lleck/PercussiveInterface-3/4_Layer_Board/Notes.txt

###############TO-DOs###########################################
*IMPACT
    |
    |___
        * via Hall effect sensors (how to calibrate ?)
          enough resolution via 3.3 reference voltage?
          switch to teensy 3.6 with 1.2Vref ?

        Interpolation for radial position detection ?

                distance between sensors 7mm
                ---|___|---|___|---|___|---|___|
                 S  7mm  S  7mm  S  7mm  S  7mm

        algorythm could possibly consider nonlinear readings (thus threshold) along the radial sensor array
        --add readings of neighbours, check for threshold and calculate proportional distribution of reading, for maximum radial resolution

        possibly one gets away with a resolution of 2*NumSensors per AngularReading. checking for 64 tresholds/ positions on the radial dimension. One reading perpendicular to each Sensor plus one reading perpendicular to the middle between 2 Sensors

*VELOCITY:
 While we hope to have reasonable time between single impacts on the skin (e.g. 400bpm = 6,67Hz) there will be a sort of phasing in the readings as they will either occur while the magnet is falling or rising. At 75 Hz there is ca. 10 readings between impacts at stupidly fast drumming of 400bpm, hopefully enough to average out the position.
 A time measurement between a first and a second treshold could possibly generate usable velocity readings if the rotor wasn't moving.
 With a moving Rotor we get a local samplerate of the rotational Frequency (e.g 1500rpm = 25Hz / 4500rpm = 75Hz)
 For reliable velocity readings we need to track the nanoseconds until a certain peak is reached, thus we need a much higher samplerate.

 Sampling another impact Sensor for the whole surface at a higher rate could provide velocity readings which we could map to position readings.

*SURFACE / Sticks / Hands etc.:

 -When hitting with the hands, capacity measurements of a steel mesh drumskin could provide impact readings
 -If using the hands, we want to break down different regions of the hand and mark them with magnets in order to derive useful parameters for synthesis. Gloves are a reasonable result adressing those needs.

 -When using Sticks, the readings are less complex but capacity is harder to derive. Sticks might connect to a ground plane through a thin wire, when using a metal mesh skin

 -Velocity sensing below the Skin allow for a different design of the skin. even a translucent layer of plastic with a film of silicon for the rebound, a standard Meshhead or else is possible

 -other Possibilities:
   Gauge Sensors, Piezoelements, resistive Sensors (velostat)

 ################ Component Details #############################

*SS39ET Hall Effekt Sensor
https://www.farnell.com/datasheets/2007294.pdf
    -3.3V
    -6mA (192mA)
    -1.4mV/Gauss -> lower reference Voltage in µC
    -response time 3µS
    -measures magnetic polarity

*Radial-Ring_Magnets
    -outer southpole -> left Hand
    -outer northpole -> right Hand

*APA 102 2020 RGB LED
https://www.mouser.com/datasheet/2/737/APA102_2020_SMD_LED-2487271.pdf
    - 5V
    - 40mA  max. each white full brightness -> 2A
    - adressable
    - ca. 0.5A for 64 leds or less with lower brightness (adafruit)

*µC Teensy 4.1
    - 3.3V (5V supply input)
    - ca. 100mA max
    - 600 mHz M7 processor
    - 2 adc
    - AREF = Supply 3.3V (Teensy 3.X can go lower)
    - interleaved reading possible

################ Sensor Data Transmission #####################
*ESP-01
    - unstable firmwares (server crashes)
    - as OSC Client
    - has OSC Library (https://github.com/stahlnow/OSCLib-for-ESP8266)
    - or NodeMCU LUA Firmware ?

*Serial via IR Light (open optocoupler)
    - less parts, no network hustle
    - retro-compatible
    - 5 pin midi jack on the instrument
    - low resolution

############### Motor PWM from RPM transmission #################
Motordriver Board needs updated PWM for stabilisation of the rpm

*Serial via IR Light
    -TO-DO: speed Test/ calculation

*ESP-01 Wifi transmission could serve both needs
