lleck/PercussiveInterface-3/Master_Thesis_Lukas_Leck.pdf

# MEMBRANE SURGERY

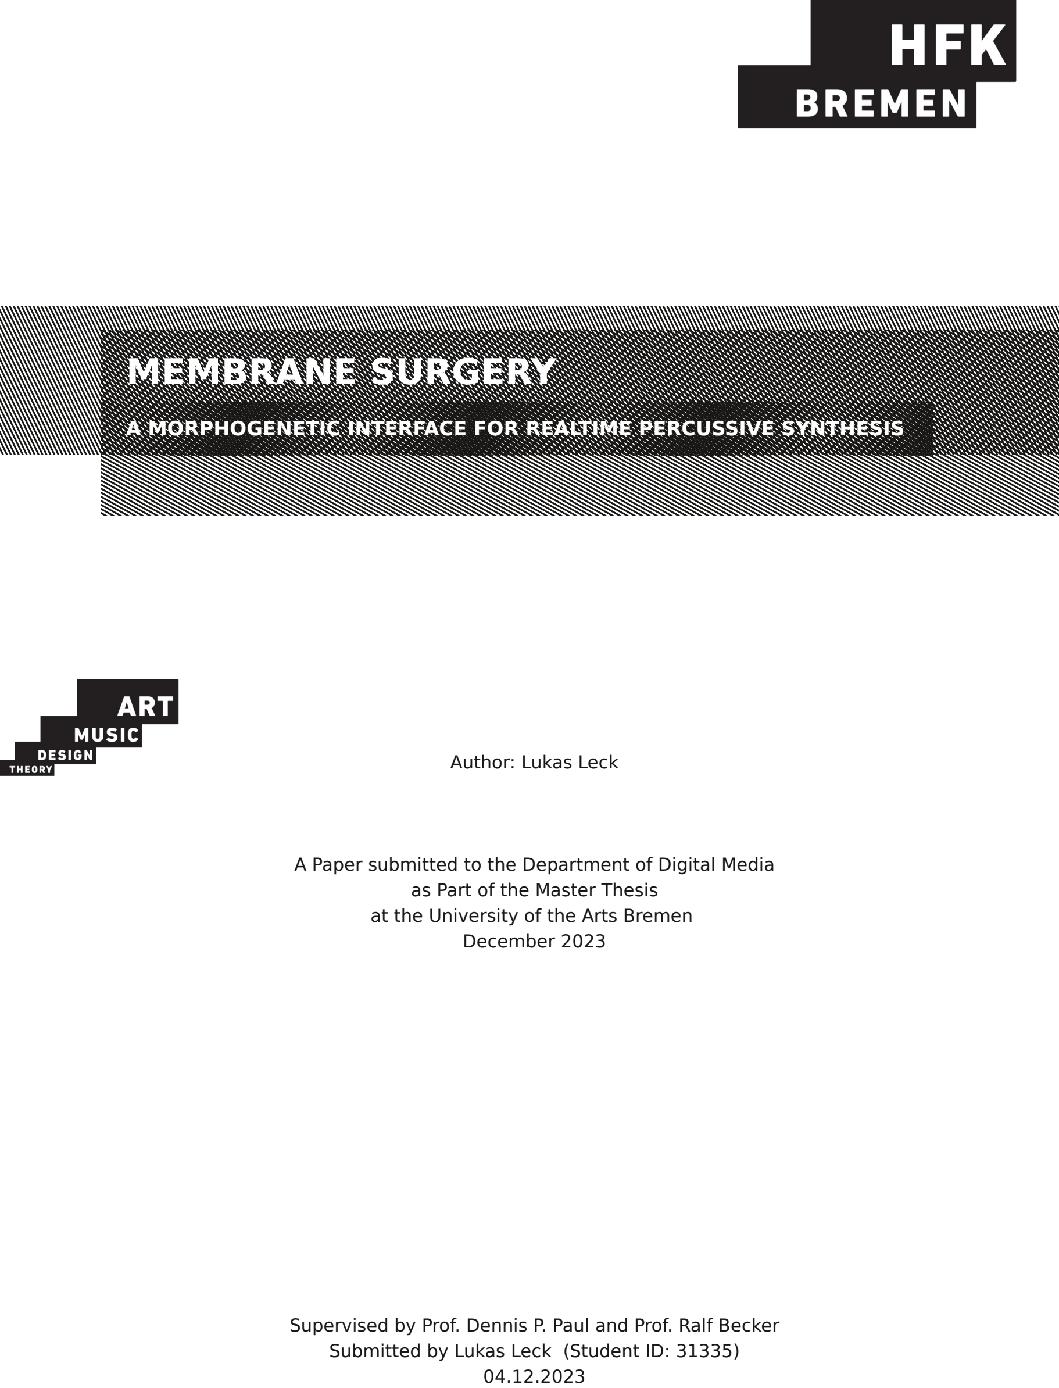
[picture p1: page 1]

Author: Lukas Leck

A Paper submitted to the Department of Digital Media as Part of the Master Thesis at the University of the Arts Bremen December 2023

Supervised by Prof. Dennis P. Paul and Prof. Ralf Becker Submitted by Lukas Leck (Student ID: 31335) 04.12.2023

A MORPHOGENETIC INTERFACE FOR REALTIME PERCUSSIVE SYNTHESIS

Membrane Surgery - written submission of the master thesis - Lukas Leck 2023

### TABLE OF CONTENTS

ABSTRACT
1 | INTRODUCTION
2 | RELATED WORK
2.1 | percussive interfaces
2.2 | position data
2.3 | display interfaces
3 | METHOD
3.1 | brief description
3.2 | design decisions
3.3 | electronics design
3.4 | circuit board design
4 | FUTURE WORK AND DISCUSSION
5 | REFERENCES
5.1 | Literature
5.2 | Images
6 | SCHEMATIC

3
4
5

7

12
13

14

Membrane Surgery - written submission of the master thesis - Lukas Leck 2023

### ABSTRACT

This paper describes a musical interface built to control percussive synthesis algorithms in real time. This interface records data about the position and intensity of a strike on a mesh fiber drum head, while projecting a full color display onto that very head. The display is created by the means of a persistence of vision (POV) setup, whereas the data for synthesis is captured by an array of magnetic field sensors and a single near field optical sensor. This interface could be used as a controller to perform with many different synthesis algorithms or dedicated synthesizers. The integrated display allows for the interface to take all kinds of shapes in order to assist the performer in controlling the targeted medium. It could provide visual feedback representing certain synthesis parameters, split up the drum head into smaller zones, plot text or even draw animations. The target is, to offer a platform for the development of dedicated applications focused on the percussive performance.

Membrane Surgery - written submission of the master thesis - Lukas Leck 2023

The relentless advance of display based interfaces into every aspect of our life, has not stopped at the musical domain. In the recent century a plethora of music software for touch-screen devices has been released. The simultaneous increase in computing power allows for complex sound synthesis, sophisticated enough to render the iPad a legit musical instrument to perform on stage. Hence the popularity of those platforms, the average consumer touchscreen device lacks a lot of features of a dedicated musical instrument or interface built for live performance and stage environment. This is particularly true when it comes to percussive interfaces, as the nature of the physical interaction of the drummer with the drum limits the design possibilities of those interfaces compared to those of e.g. a keyboard player. A glass covered touch screen just can't take the beating.
This paper describes the design of a digital percussive instrument that is capable of drawing a graphical interface onto a circular drum skin, while concurrently collecting and processing various data points representing position and force of impacts measured by
various | sensors | below | the | skin.
The | resulting prototype | represents | a
percussive interface for sophisticated drum
synthesis | with | the | flexibility | of | a
touchscreen device while providing the morphology of a drum as expected by the percussionist.

To achieve this, a mesh fiber drum head as used in electronic drum kits is augmented by a rotating disk beneath, which holds an array of multi color RGB LEDs as well as an array of magnetic hall effect sensors. On the display side the led array provides for the technical prerequisites of a persistence of vision (POV) display known to many by gadgets like led desk-fans which employ the technique to draw patterns or messages with their spinning rotors (Figure 1).

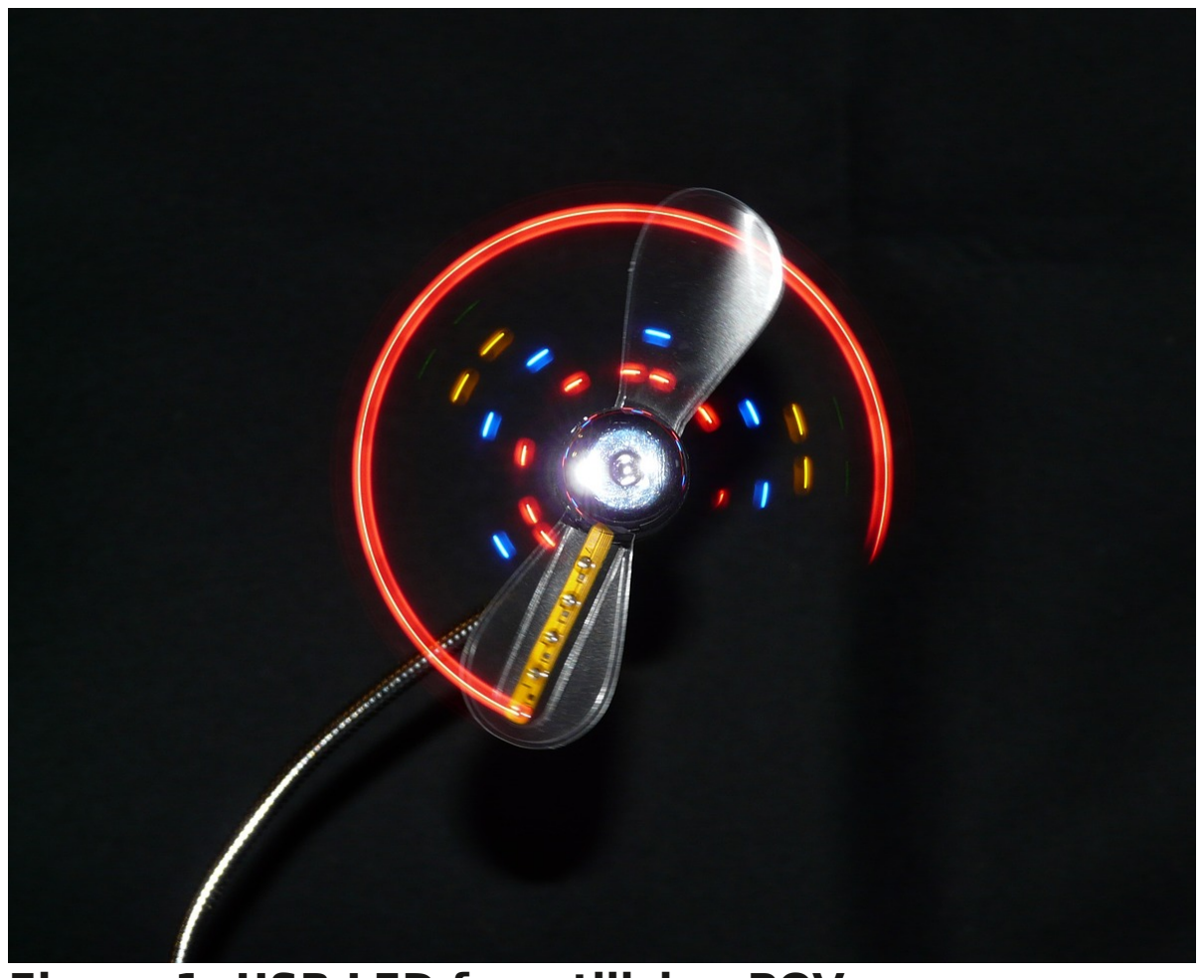
[picture p2: figure]

On the sensor side the same principle is somewhat turned around by adding an array of hall effect sensors, which are used to record data about magnetic fields above the drum head. All incoming and outgoing data is processed by an ESP32 micro controller (µC) sitting on the same PCB as the LEDs and sensors. The disk is rotated by a dc motor and the power is transmitted to the rotating body through a conductive coil setup as known to many by wireless charging modules for smartphones. To complete the design the tips of the drumming sticks need to be equipped with small permanent magnets.
The current design offers a rugged drum with natural physical response that can take a beating and is capable of drawing a full
color | interface | onto | the | skin | while
representing many relevant interactions with high resolution data points.

### 1. INTRODUCTION

Figure 1: USB LED fan utilizing POV

Membrane Surgery - written submission of the master thesis - Lukas Leck 2023

1)https://www.keithmcmillen.com/products/boppad/2)https://korg.com/de/products/en/drums/wavedrum/

A broad overview of the strategies used to sample useful data in percussive interfaces is provided by Tindale et al.
[1]

. The large
majority of electronic percussive instruments and controllers on the market make use of piezo transducers which translate impacts into voltage and can even be used to determine the position of strokes when put in relation to another. This can be seen today in many electronic drum pads and kits of various manufacturers. Another common method is the use of force sensing resistors (FSR) made of a material that varies in electrical resistance relative to the force applied. The cross-talk between adjacent sensors is decreased massively compared to piezo elements. These can also be found in various percussive interfaces on the market, with a prominent example being the Bop Pad¹⁾

. Yet another technique to obtain useful data for percussive synthesis is the use of microphones. The Wavedrum²⁾

is a very
successful | implementation | combining
original sound with synthesis and sound-processing based on the input of three contact mics.

One can already see different attempts to make use of position data in the percussive interfaces described, but there are methods focusing more on that topic. An early example being the radio baton[2] developed

### 2. RELATED WORK

### 2.1 percussive interfaces

### 2.2 position data

3)https://sunhou.se/sensorypercussion by Max Mathews at the infamous Bell Labs in the 1970s. It makes use of two radio emitting batons that are used on a rectangular drumming-surface with radio antennas. A concept birthed as a three
dimensional | computer | mouse | further
developed by Matthews to easily perform sheet music with an individual touch. Here one can already see a potential percussive interface generating high resolution position data in three dimensions. From that point on the increase in computing power has
opened | up | a | lot | of | possibilities.
Sophisticated realtime input data analysis is performed by machine learning algorithms in an approach by Tindale et al.
[3] paving
the way for products like the Evans Hybrid Sensory Percussion³⁾

. Another method worth
mentioning is the use of computer vision.
T. Mäki-Patola et al.
[4] used a webcam
mounted underneath the skin of a djembe drum to obtain a 3d image of the hands above the skin by analyzing the shadow
displacement. | Proper | lighting | is | an
important aspect in this setup, as one can guess.

The touchscreen is the number one interface for human machine interactions since the manufacturers of smartphones
have | conquered | the | markets | of all
developing | economies. | People | quickly
adopted their behavior to the new and fascinating coplanarity of input and output. Interface designers put great effort into nurturing the users memory for the new and competing gestures. While many young folks will intuitively develop the skills to interact with screens on their very surface, other folks are having a hard time keeping up with speed. A feeling of nostalgia is

### 2.3 display interfaces

Membrane Surgery - written submission of the master thesis - Lukas Leck 2023

FSRs and multi color LEDs, their method gets much closer to an actual color display,
capable | of | drawing | many | different
interfaces. Finally a project based on a traditional glass covered touchscreen is worth mentioning here, as the sound synthesis performed in this device is very closely attached to the interactions on that screen. Victor Zappi et al.
[5] made a giant
touchscreen interface for their physical
modeling | synthesis | algorithm | when
developing "The Hyper Drum Head". The performer draws free-form shapes onto the screen, thereby creating a virtual physical space in which the sound-waves, excited by strokes on the screen, resonate. This way a magnitude of possible sounds can be created very creatively. While this example lacks the possibility to beat the interface with a stick, it clearly showcases the potential that flexible display interfaces can offer the developer and the performer.
surrounding | dedicated | single | purpose
interfaces, equipped with knobs, buttons and tiny segmented displays. A feeling that has paid in its contribution for a boom of electronic music devices. The market is flooded with tiny little synth boxes, compact drum machines, samplers and effect units often times emphasizing the analog nature of their sound synthesis. In other examples they are based on building a dedicated interface around a microcomputer executing a single piece of musical software. If there is something to learn from these observations then it's potentially that there are certain shortcomings of the ubiquitous touch-screens especially when it comes to the creative musical process. At the same time nostalgia will pass with each gene-ration and the benefits of on-screen interactions are simultaneously developed by musicians and researchers in the field. Thus there are a few examples of (potentially) percussive on-screen interfaces to discuss here.
A certain range of midi controllers can be
summarized | under | the | term | 'grid-
controllers' and one of the first appearances is the monome⁴⁾

. The smallest version, the monome-64 is little more than an eight by
eight | momentary | button | matrix | with
a back-light under each of its translucent silicone pads. It was originally developed to control the visual programming environment MaxMSP⁵⁾

. The possibility of adjusting the interface with different illuminations makes it a versatile and effective tool, yet far from offering any percussive qualities. The field of inventions and products building on the same concept reach into a area that is slightly more relevant for percussive use, by replacing the buttons with sensors such as FSRs. The Linnstrument 128⁶⁾ by Roger Linn might be an example worth mentioning here. A concept transcending further from the limitations of a grid is the Erae Touch⁷⁾
by | the | french | company | embodme.
By scaling up the grid resolution of both

4)https://monome.org/
5)https://cycling74.com/products/max6)https://www.rogerlinndesign.com/linnstrument7)https://www.embodme.com/

Membrane Surgery - written submission of the master thesis - Lukas Leck 2023

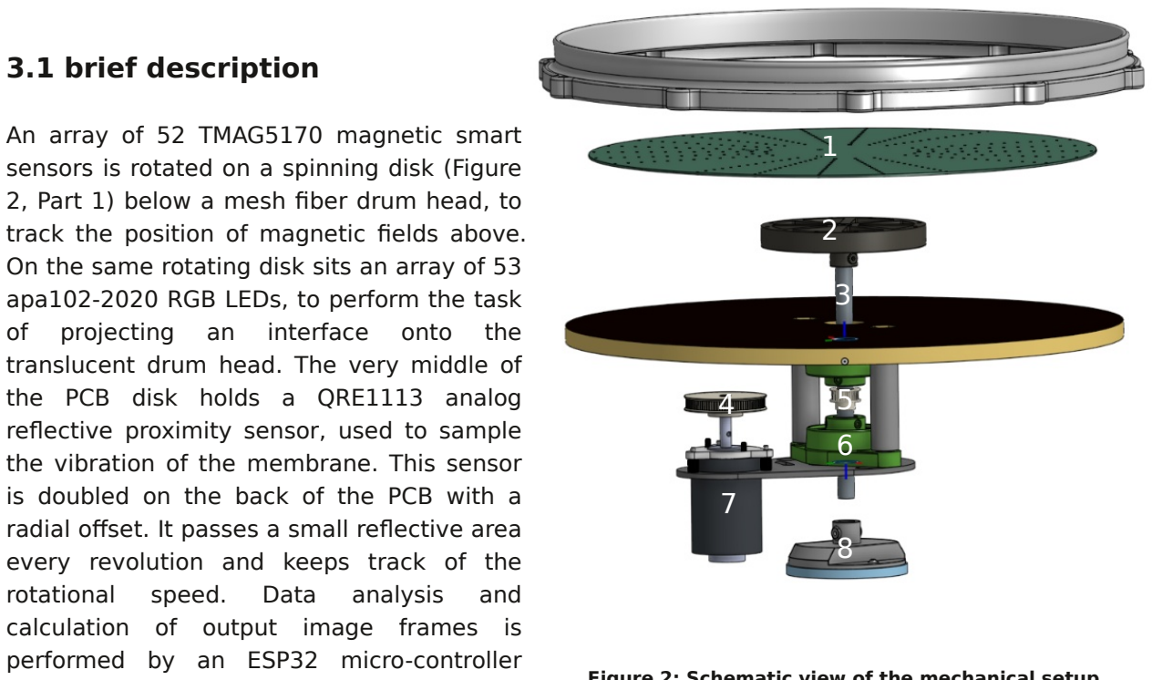
[picture p3: figure]
An array of 52 TMAG5170 magnetic smart; of projecting; interface; onto; the; the PCB disk holds a QRE1113 analog; every revolution and keeps track of the; rotational; speed.; Data; analysis; and; calculation of output image frames is performed by an ESP32 micro-controller; 3.1 brief description

Diving into the technical details of this
method | can | partly | be | achieved | by
describing the path of design decisions and
preceding | experiments | during | the
development. Searching for a way to display an interface onto a drum head there are several options coming to mind. A limitation being the possibility of the membrane to vibrate, in order to achieve a natural behavior and respond as expected by the drummer. Thus the displaying devices needs to shine the interface onto that membrane without touching it. This is where projection comes to mind as the image can be mapped to the shape of a drum easily, although this comes with the cost of a projector that either fits into the drum or a setup that

### 3. METHOD

1

sensors is rotated on a spinning disk (Figure 2, Part 1) below a mesh fiber drum head, to track the position of magnetic fields above. On the same rotating disk sits an array of 53 apa102-2020 RGB LEDs, to perform the task

translucent drum head. The very middle of

reflective proximity sensor, used to sample the vibration of the membrane. This sensor is doubled on the back of the PCB with a radial offset. It passes a small reflective area

(µC) sitting on that same disk. The disk is mounted on top of a 12mm hollow shaft (Figure 2, Part 3) with a 3d printed adapter (Figure 2, Part 2). The shaft is supported by two ufl203 bearings (Figure 2, Part 6) and driven by a 12V dc motor (Figure 2, Part 7) connected by the means of a GT2 timing belt. In order to drive the disk at high speeds, a transmission ratio of 1:3 is realized through the use of a 30 teeth pulley on the 12mm shaft (Figure 2, Part 5) and a 90 teeth pulley on the motor shaft (Figure 2, Part 4). Power is transmitted wireless to the rotating parts by the means of a conductive coil setup as used to charge smartphones without a cable. The power cables are passing the core of the hollow shaft. The receiving coil with its circuitry is attached at the lower end of the 12mm shaft through a 3d printed part (Figure 2, Part 8). It is facing the static transmitting coil placed below with a little air gap in between.

### 3.2 design decisions

Figure 2: Schematic view of the mechanical setup

Membrane Surgery - written submission of the master thesis - Lukas Leck 2023

As discomforting it may be and has been to the author, one is not getting away without some numbers and cold blooded math at this point. In order to get an idea, if the design meets the real world needs, there are several numbers one should gather to perform some calculations. These can be justified assumptions, as for example the
playing | speed | of | the | percussionist
performing the instrument. Or they can be standards that have established over the course of history, like the upper limit of 10ms latency in realtime sound synthesis. Ignoring such a limit would plainly render any musical controller useless, even for the amateur performer with non-skilled ears. Taking the latency limit as a starting point, it is now important to walk along our signal path's and determine, which components pay into the time account. First we have our LEDs as the output path. There are many different RGB LEDs on the market. A large group of analog ones, requiring digital logic to switch them, which takes a lot of controlling outputs from the µC or output multiplexing which in return asks for more components and available space on the printed circuit board (PCB) . A second group formed by digital ones controlled through a protocol like I²C or SPI. This allows a large number of them to be connected to the µC by a few wires. To cut the story short the RGB LED aimed for in this project is the apa102-2020, mainly because it comes in a 2x2 mm package, allowing for denser pixels compared to the ubiquitous 5x5 mm package. It features a standard SPI interface and a refresh rate of 20kHz translating to
0.05ms | per | refresh. | That | is | plenty
enough to perform some visual magick.

requires several parts to be setup and calibrated each time. Either way one shall not get into the way of the light beams with your hands, sticks or sensoric electronics. A different approach would be a form of circular LCD screen that fits under the drum head leaving a gap between the membrane and the display. The lack of available circular displays bigger the size of a smart watch made for an easy decision. Which leads us to the concept of POV displays. This concept further illuminated in the next chapter, gets along with a single array of rotating LEDs to produce a circular image leaving enough space on the rotational body for further electronics such as sensors to accumulate data of the overlaying surface and space above. While growing fond of the idea of a spinning display, this imposed new problems on the overall design.
First of all, a decision had to be made, which components of the design should be spinning around and which parts can remain static. Most of all the question, how to interconnect these parts. In order to stop the pondering about, a decision has been made to find a way of fitting all electronic parts onto the spinning body. This is leaving only two connections (power and ground) to find their way onto the spindle. A problem of a very different kind comes with the indifference of humans visual and auditory perception. Where an array of LEDs can make for a perfect illusion of a fluid image when switched and spinned at rather modest frequencies, the human ear is capable of perceiving latencies of a few milliseconds, with musicians ears being unsettlingly faster than the average. This means the sensoric electronics need to perform their task much faster than the LEDs in order to provide data for sound synthesis at an acceptable rate. This has obviously influenced the last major part of the design decisions in this project being the choice of electronic components.

### 3.3 electronics design

Membrane Surgery - written submission of the master thesis - Lukas Leck 2023

Those numbers are kept in mind nonethe-less. Facing the input side of the project, one is confronted with the sheer infinity of different sensors available. Before settling on a certain type of sensor it seemed wise to decide on some of its specifications first. That way one hopefully ends up with a greater choice of components. To gather these specs we are again assuming a target latency below 10ms. But before diving into the datasheets one has to realize that the very first limiting factor here, is the speed of rotation. While many digital sensors offer update rates of several thousand Hertz , it is the rotational frequency that determines how often a certain sensor is passing point x on the surface. Soon one comes to the realization, that for "musical" update rates,
velocities | of | hundreds | of | thousands
rotations per minute are necessary (e.g. 5ms(p) ≙ 5kHz ≙ 300.000 rpm). Time to look further into the data one actually needs to perform the synthesis of a percussive sound and how they relate to our timing problems.

A percussive sound (Figure 3) consists of the onset marking the very beginning of the sound, a tone or timbre consisting of certain frequencies, their relative level to another and their change over time until no more sound is present. Sounds described as percussive share a feature that is called a short attack. The overall level of the sound takes very short time to reach perceptible loudness. They are often times decaying towards silence at slower speeds from that point on, with slower decaying sounds offering more perceptible differences in tone and timbre. Looking at the data to control these parameters one can now divide them into those relevant for the timing, namely the impact on the drum head, its exact time, intensity and the duration of decay and those relevant to the timbre of the sound, namely the exact position of the impact and maybe a suggestion about the mass or size of the impacting object.
When the exact onset time of the impact is much more critical to latency, while less so is the data influencing tone and timbre, one can potentially devide these tasks in the design of a percussive interface. The critical impact detection shall however be solved before any other design decisions are made. In this method this was achieved by placing a QRE1113 infrared reflective sensor in the very middle of the PCB so that it is targeted towards the center of the drum head. The sampled data is representing the intensity of reflection, which itself is relative to the distance of the drum head. Sampling this data is achieved by the ESP32 µC and is performed with absolute priority at high enough samplerates to satisfy our latency demands. Impact-onset and duration of decay as well as the frequency of vibration are now represented. With this out of the way, one can now think about the other data relevant to this project. What kind of sensor is able to detect the presence of an object (and ideally its distance) at high enough rates, to offer useful data. Bearing in mind it is being spinned around performing the task. An optical sensor has fitted the needs earlier, though now the membrane is in its way rendering all light beam reliant methods useless. Opting for Texas Instruments TMAG5170 3d Hall effect sensor instead was done out of various reasons. Firstly, great amounts are available in stock at the time building this project. Secondly, it is priced reasonably enough to

Figure 3: A percussive sound with its maximum level almost coincident with its onset

Membrane Surgery - written submission of the master thesis - Lukas Leck 2023

polar coordinate system by the means of assigning them to an angular, radial and axial distance. The radial distance is represented by the index of the sensor in the physical array. Its distance from the center is a constant and can be further divided by the means of interpolation. The axial distance is relative to the strength of the field, which leaves us with the angular position. As described earlier, a second optical reflective sensor is attached to the bottom of the PCB at a known radial offset, passing a small reflective point once per revolution. This point is declared the reference point of 0°. By sampling the time it takes for our disk to perform a full revolution (T) one can keep track of the rotational speed as well as derive an angular displacement of the sensor array with the following formula:

T for the exemplary 3300rpm equals 1/55 seconds, resulting in ω≈345 with the unit 1/s. Now one can multiply ω with the time (t) that passed since the reference point to obtain an angle expressed in radians. This value can be multiplied by 180° and divided by π to convert it into degrees. The obtained position data is constantly updated to an array. Whenever an impact is recorded, the latest position data is collected from that array. This way the latency of data arrival at the output, relative to the impact, is kept as short as possible. Changes in position are not expected to be performed at audio rates so these can be sampled at slower rates. As the TMAG5170 sensor can detect a magnetic field a few centimeters away, it allows for the record of position data ahead of an impact, as well as the option to pipe out that data individually for contactless interaction three dimensions.

8)a comparision of the readings of two adjacent sensors, to determine a relative position inbetween double the amount on the PCB, resulting in two opposite arrays, subsequently doubling the samplerate at point x on the surface. Finally because it is a smart sensor package that offers complete signal conditioning, integrated analog to digital conversion (ADC) and the fast and stable SPI interface mentioned earlier. This interface relies on a clock signal, a data input path and a data output path shared among all devices, leaving only one individual connection - the chip select signal (CS) - which selects the slave device (TMAG5170) talking with the
master | (ESP32 | µC). | The | necessary
infrastructure is fulfilled with only two more components (ADG731 32-channel multiplexers) distributing these CS signals from two output pins of the µC to the 52 slave devices. The TMAG5170 sensors being sensitive to magnetic fields on the z-axis perpendicular to their surface mount package, offer the convenience of detecting the distance of a permanent magnet above at a rate of 20.000 samples per second. One
can | calculate | the | resulting | circular
resolution of the spinning sensor array with the following formula:

if one inserts the samplerate f(s) of 20kSps and assumes an exemplary rotation of 3300rpm, one can possibly perform 727
readings | per | revolution, | theoretically
allowing for an angular resolution of 1° with ~110Sps @ point x on the surface (alternatively an angular resolution of 0,5° with ~55Sps at point x). Combined with the possibility of interpolation⁸⁾

there is plenty of
room to experiment with the algorithm gathering the position data from the hall effect sensor array. The measured magnetic field strength can easily be mapped to a

Membrane Surgery - written submission of the master thesis - Lukas Leck 2023

mind and preferably close to the center, yet it is impossible to evenly distribute all weight, while designing a PCB like this. The long array of components cutting the circle in half, are the 52 hall effect sensors, with a small interruption in the middle by the optical sensor. The vertical array in Figure 4 are the 53 RGB LEDs above the ESP32 microcontroller, which is framed by the two multiplexers. The circuit board is designed with industrial top layer assembly

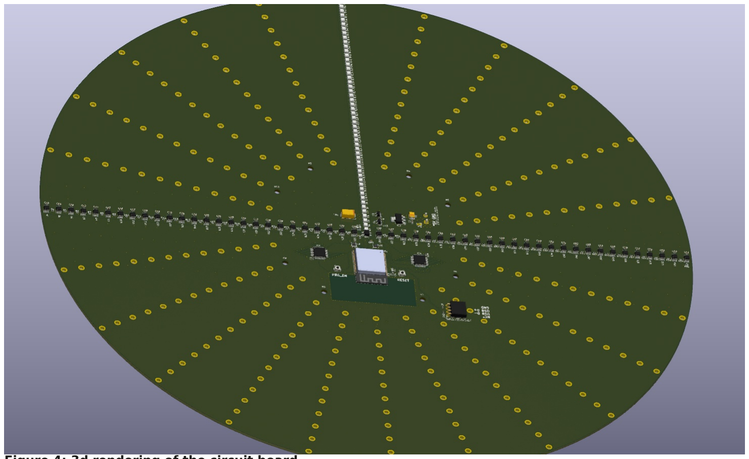
[picture p4: figure]

in mind, in order to save cost and time. As a result only three components need to be soldered by hand on the bottom side. The stackup of the board is four layers, with two signal layers enclosing a ground- and a powerplane. The full schematic of this board is attached to this document.

The design of the PCB justifies a few separate lines in order to explain its unusual appearance (Figure 4). The spinning disk mentioned repeatedly consists of this very PCB. This decision was made to reduce the overall mass of the moving parts to eliminate vibrations due to unbalance. The same reason explains the beams of 2mm plated holes spreading out from the center. These holes can be populated with small copper rivets in the necessary process of balancing the disk. The other components on the board were placed with balance in

### 3.4 circuit board design

Figure 4: 3d rendering of the circuit board

Membrane Surgery - written submission of the master thesis - Lukas Leck 2023

### 4. DISCUSSION AND FUTURE WORK

At the time this paper is written, the prototype has yet to be assembled and programmed. The preceding text resembles an in depth description of the concept and design of this instrument, and documents the work incorporated to this point. The targeted implementation of this project resembles an early prototype. It has yet to be tested in various use cases to reveal all its potentials and deficits. There are certain considerations for improvements of the overall design, that came up during the process of development, which ask for further investigation. As usual with a project of this scope, one has to decide for a moment to actually release the work into existence, postponing a lot of considerations to a future version. To name a few here, the mechanical design for example, is based on the hope to omit problems of instability by
choosing | very | sturdy | heavy | parts.
Therefore, a future version may become
substantially | lighter | and | slimmer | by
investigating | further | into | the | actual
mechanical | loads | on | the | chassis.
Furthermore the choice of the skin and the hoop were first of all based on availability. The skin shall be evaluated in its qualities as both a membrane and a canvas for the graphical interface. The hoop might be replaced by a flatter type in order to reveal more of the outer perimeter of the skin. The motor driving the disk might as well be exchanged in order to save space and cost, as the one used in this project is quite bulky and offers far more torque than required in this project. Additionally the whole drive train could potentially see improvements in order to silence emerging sounds. Which leads to the question of the final enclosure for the drum, which obviously is a substantial part of its appearance, as well as the amount of noise emitted from the drive train. In that regard a traditional drum format is targeted, where the performer can comfortably place it on the lap as well as the potential to mount it onto a stand, when performed in conjunction with a set of other percussive instruments or a drum set. All future improvements set aside, it already appears, how this interface can serve as a novel platform for the development of specific synthetic percussive applications. The characteristics of this interface are calling for programs developed to embrace them. In other words, it may perform well enough as a drum pad, by visually dividing up its surface to control different sounds in existing software. The bigger potential however, lies in the careful mapping of all the different output parameters to certain sonic features. It requires a corresponding responsive user interface projected onto its skin, guiding the performer through the manipulation of that membrane. This interface calls for the possibility to integrate the creation of these interfaces into itself, making the setup an intuitive creative process. Many such programs could be developed and performed from that single interface. This way it could be turned into an evolving organism, revealing its true morphogenetic features. To approach these daring fantasies a lot of UI work is ahead of the developer.

Membrane Surgery - written submission of the master thesis - Lukas Leck 2023

[1] A. R. Tindale, A. Kapur, G. Tzanetakis, P.
F. Driessen, and W. A. Schloss. A comparison of sensor strategies for capturing percussive gestures. In NIME, 2005
[2] M. Mathews. The radio baton and conductor program, or, pitch, the most important and least expressive part of music. Computer Music Journal 1991
[3] A. Tindale, A. Kapur, G. Tzanetakis, and I. Fujinaga. Retrieval of percussion gestures using timbre classification techniques. International Symposium on Music Information Retrieval, 2004
[4] T. Mäki-Patola, P. Hämäläinen, and A. Kanerva. The augmented djembe drum -sculpting rhythms. In NIME, 2006.
[5] Victor Zappi, Mike Frengel, Andrew Stewart Allen, Sidney Fels. The Hyper Drumhead: A Musical Instrument For The Audio/Visual Manipulation Of Sound Waves. SIGGRAPH Conference, 2022

Figure 1: Image of a rotating led fan shot by the user Hans-2
file accessed on 30.11.2023 link:
https://pixabay.com/photos/fan-rotation-wing-subjects-52107/

Figure 2: screenshot taken from CAD software used in the design process

Figure 3: screenshot taken from a waveform of a ppercussive sound, representing loudness relative to time

Figure 4: 3d rendering of the circuit board designed in the free software KiCAD EDA Suite

5. REFERENCES | 5.1 Images

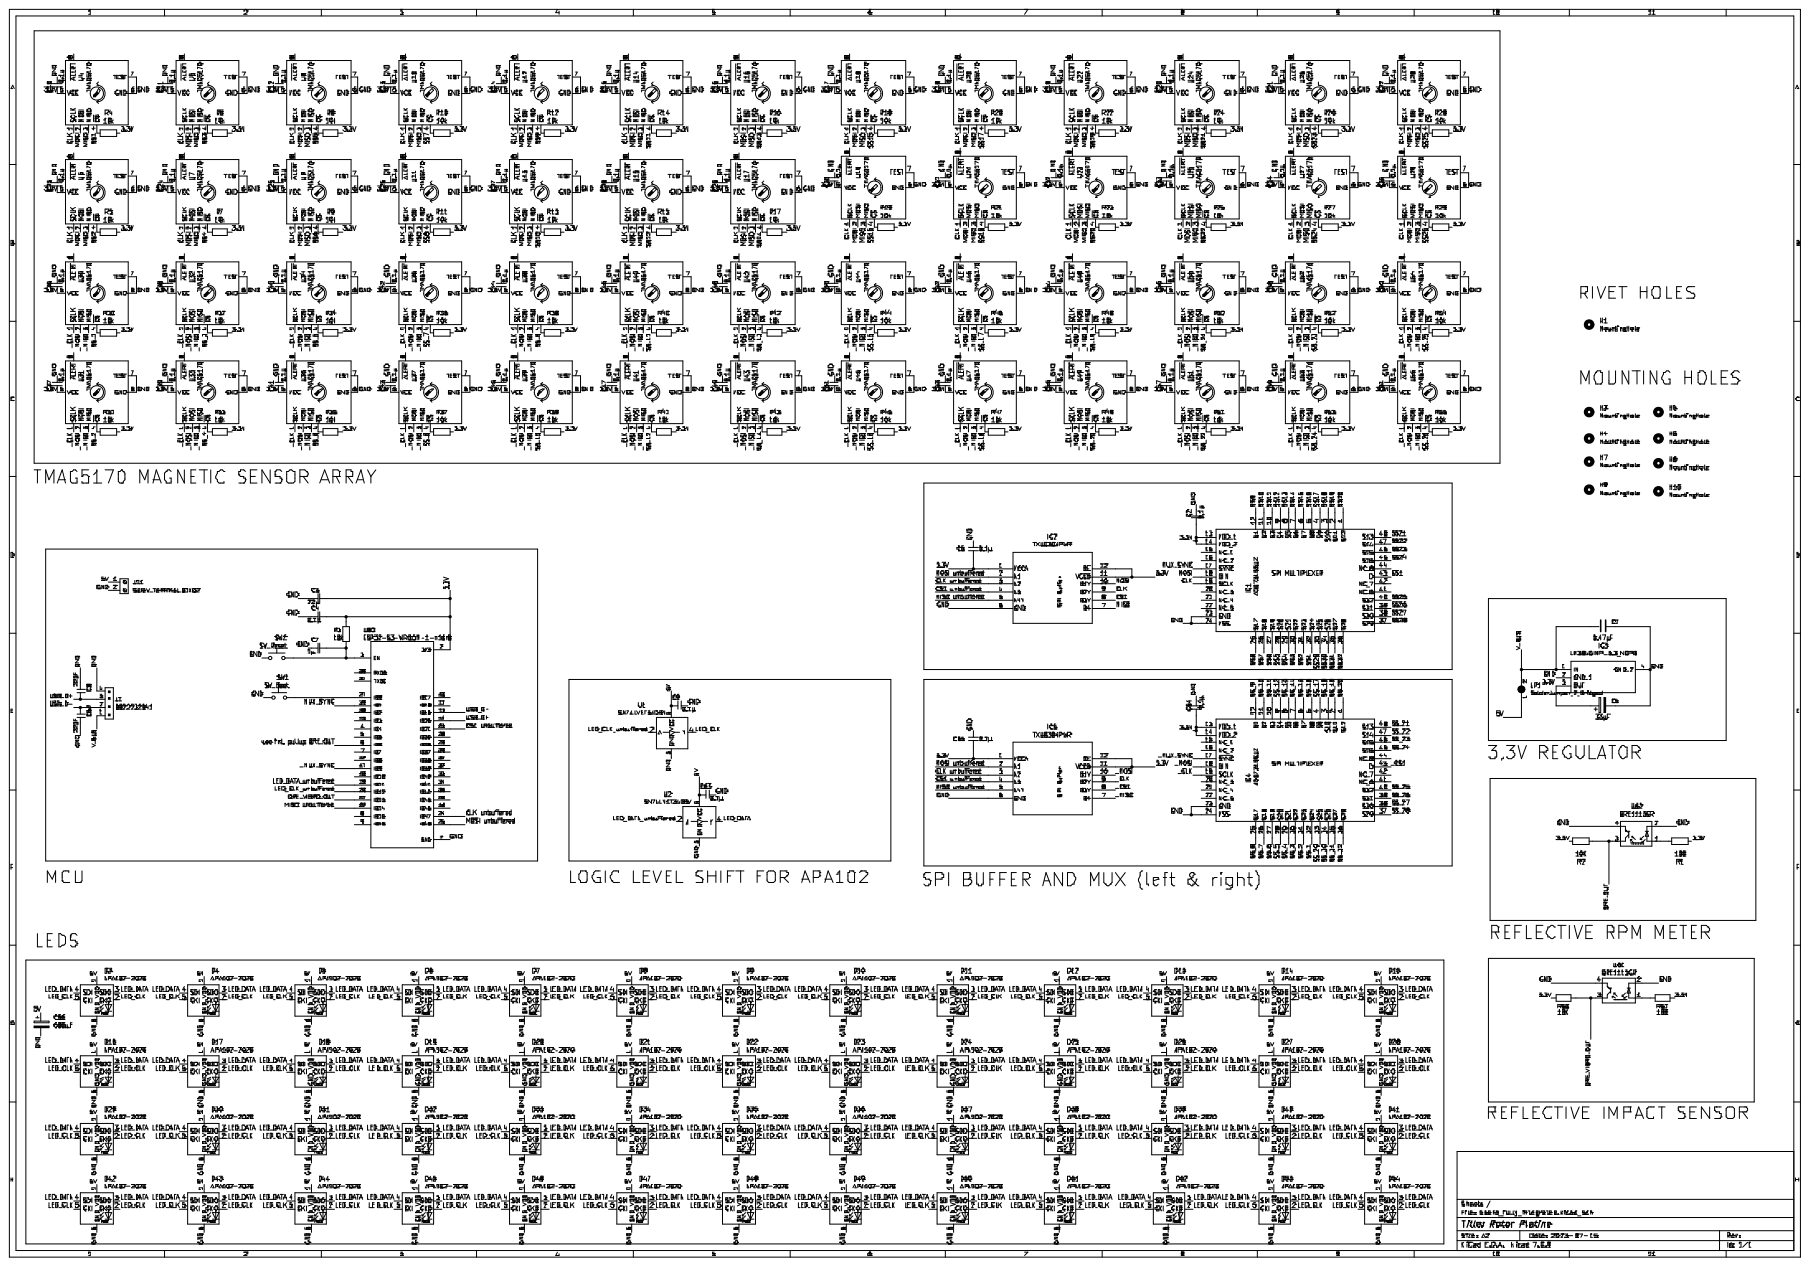
[picture p5: page 14]
