lleck/PercussiveInterface-3/percussiveInterface-3.2/ARRAY_Connector.png

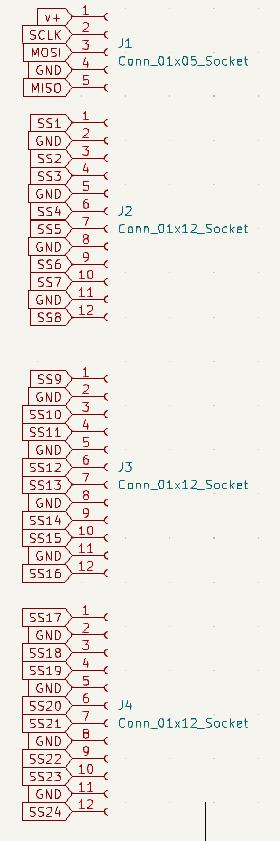
percussiveInterface-3.2/ARRAY_Connector.png
