lleck/PercussiveInterface-3/percussiveInterface-3.2/magneto_array.png

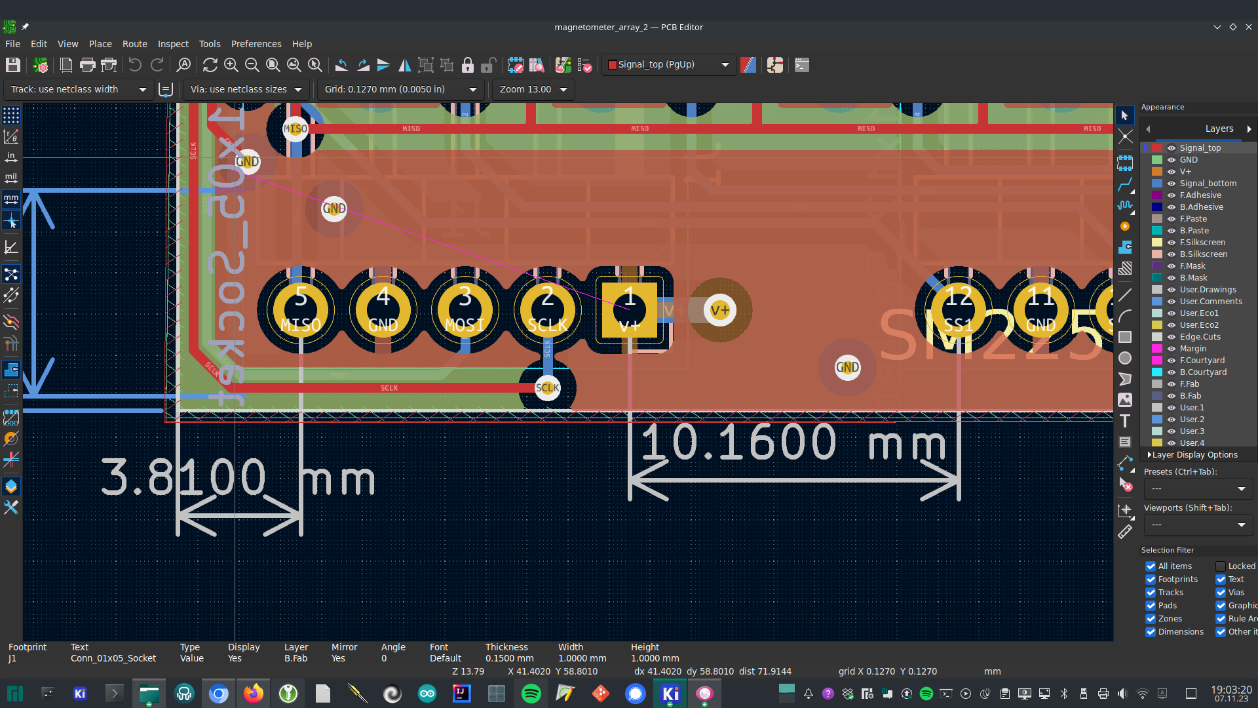
percussiveInterface-3.2/magneto_array.png
