lleck/PercussiveInterface-3/percussiveInterface-3.2/new_board_fully_integrated/board_fully_integrated_zoom_2.png

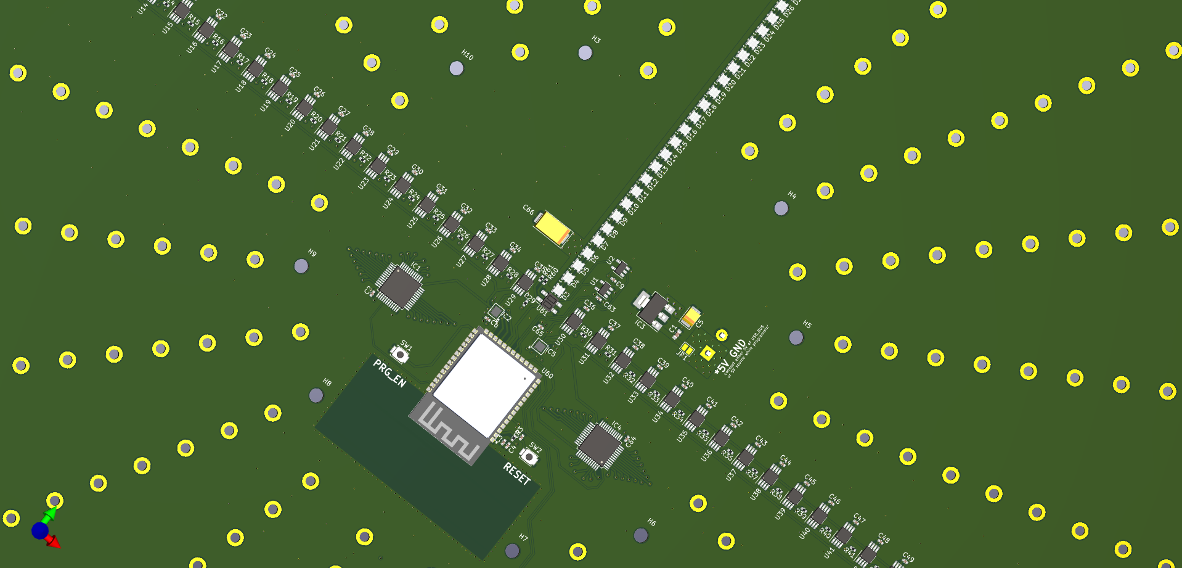
percussiveInterface-3.2/new_board_fully_integrated/board_fully_integrated_zoom_2.png
