lleck/PercussiveInterface-3/percussiveInterface-3.2/Screenshot_20231107_152231.png

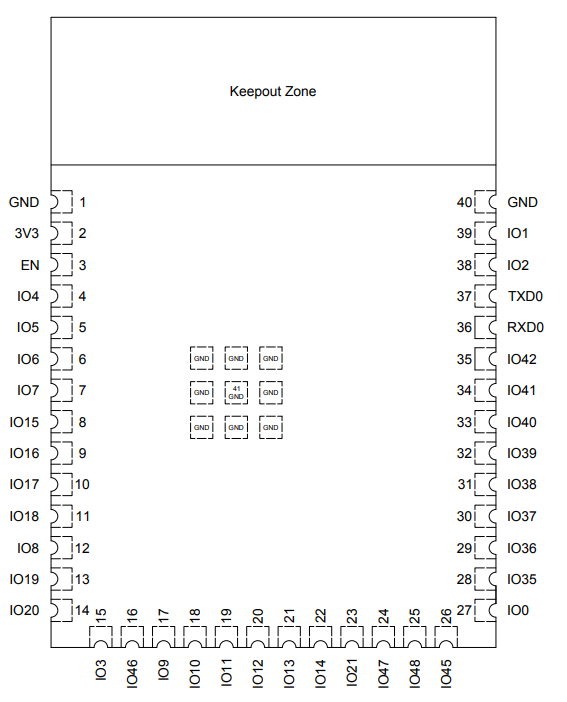
percussiveInterface-3.2/Screenshot_20231107_152231.png
