lleck/PercussiveInterface-3/percussiveInterface-3.2/Screenshot_20231114_114413.png

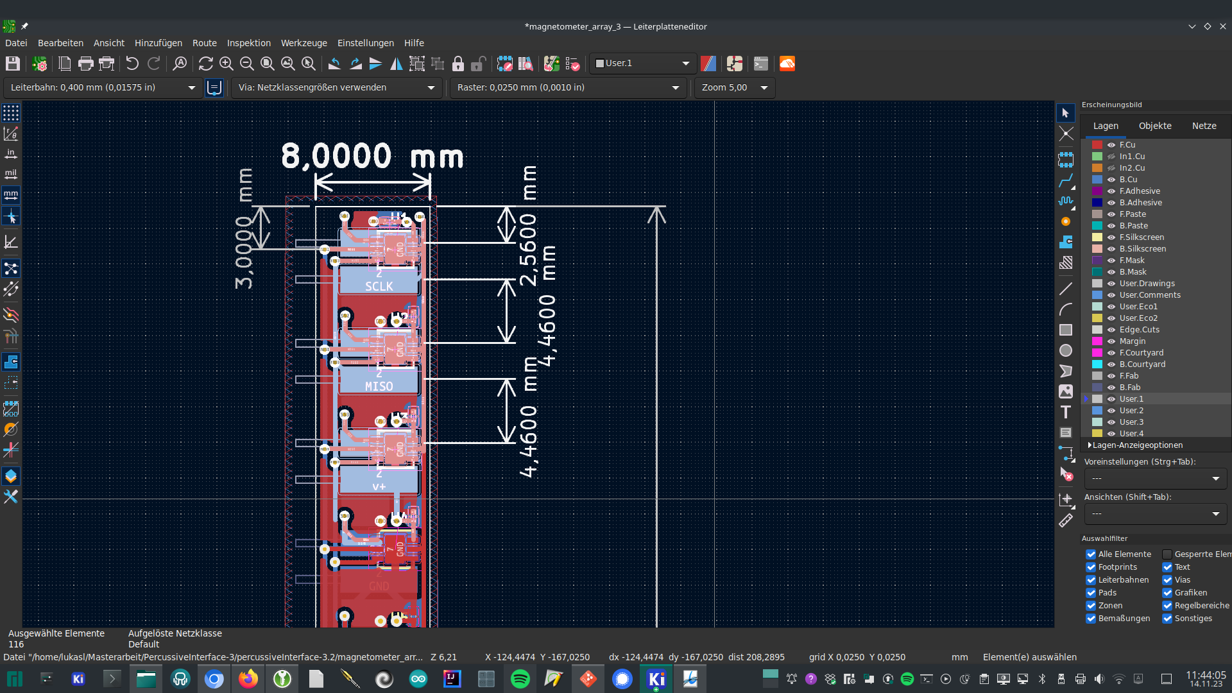
percussiveInterface-3.2/Screenshot_20231114_114413.png
