lleck/PercussiveInterface-3/percussiveInterface-3.2/Screenshot_20231114_115530.png

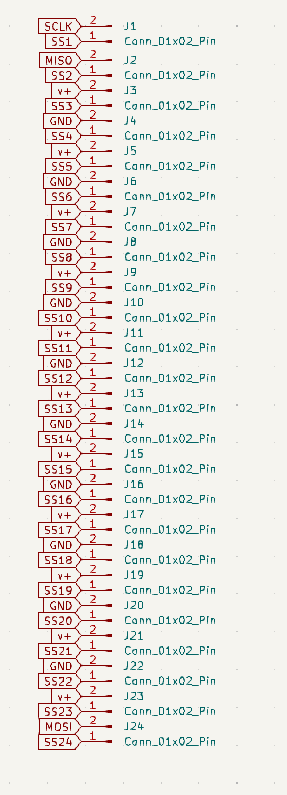
percussiveInterface-3.2/Screenshot_20231114_115530.png
