lleck/PercussiveInterface-3/percussiveInterface-3.2/Screenshot_20231114_170810.png

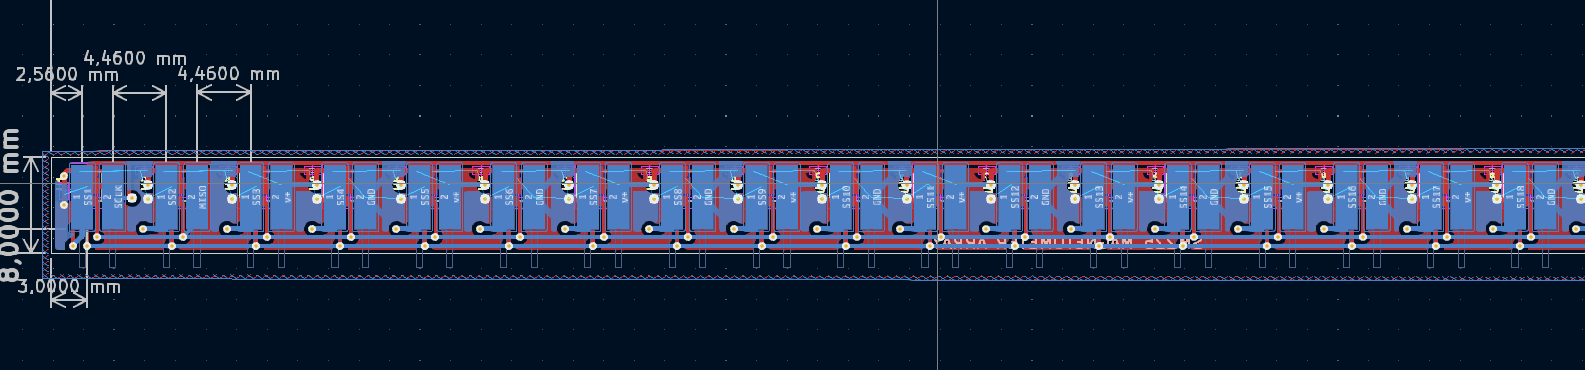
percussiveInterface-3.2/Screenshot_20231114_170810.png
