lleck/PercussiveInterface-3/percussiveInterface-3.2/main_board_4_jlc/jlcpcb/goods_nomenclature_code.png

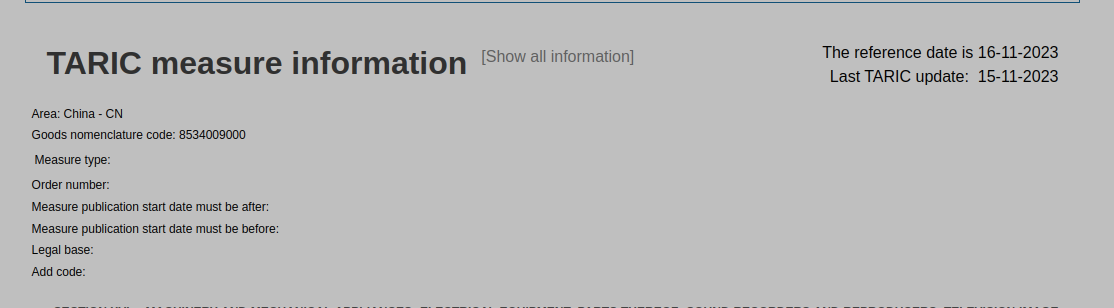
percussiveInterface-3.2/main_board_4_jlc/jlcpcb/goods_nomenclature_code.png
