lleck/PercussiveInterface-3/drill_template.stl

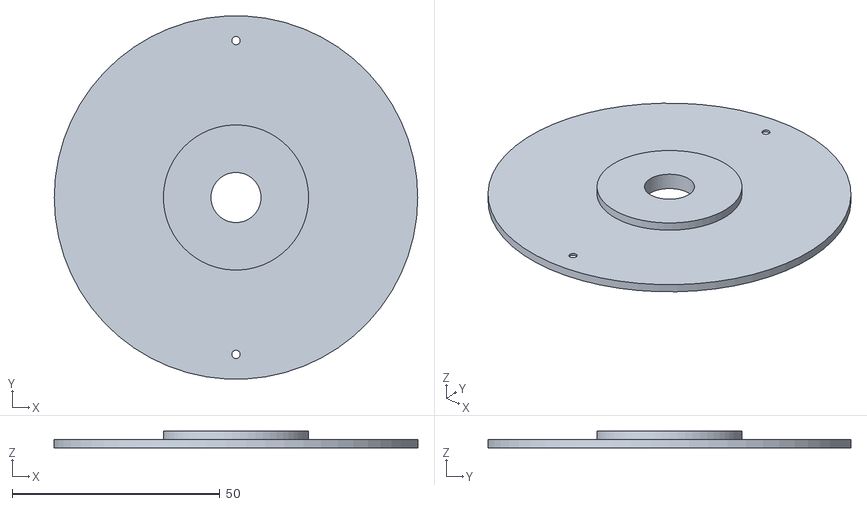
[picture p16: CAD file, 2024-01-07]
drill_template.stl
87.5 x 87.4 x 4.00
