lleck/PercussiveInterface-3/Footprints/BSW-112-04-T-S/BSW-112-X-X-S.step

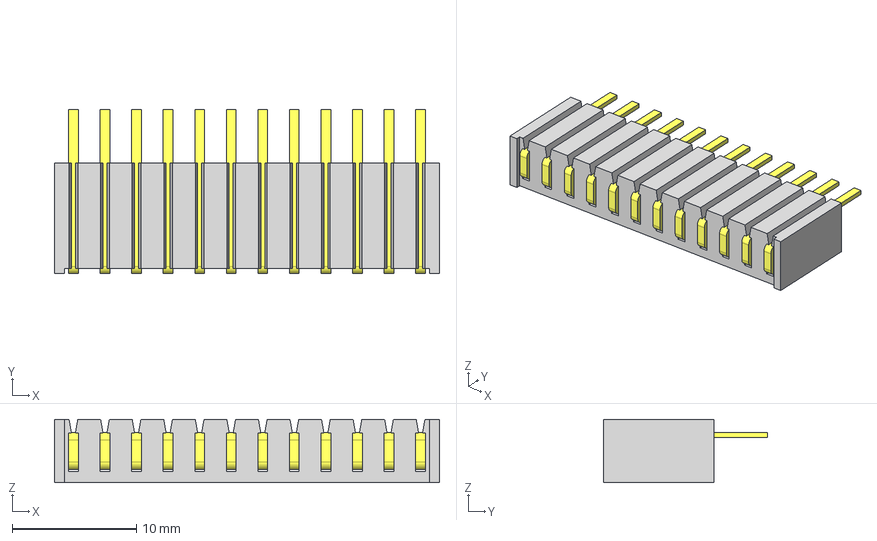
[picture p17: CAD file, 2023-11-09]
Footprints/BSW-112-04-T-S/BSW-112-X-X-S.step
31.0 x 13.2 x 5.08 mm
C-8-5-01-12-S
BSW-12-04-S_socket
