lleck/PercussiveInterface-3/Footprints/BSW-120-X-X-S/BSW-120-X-X-S.step

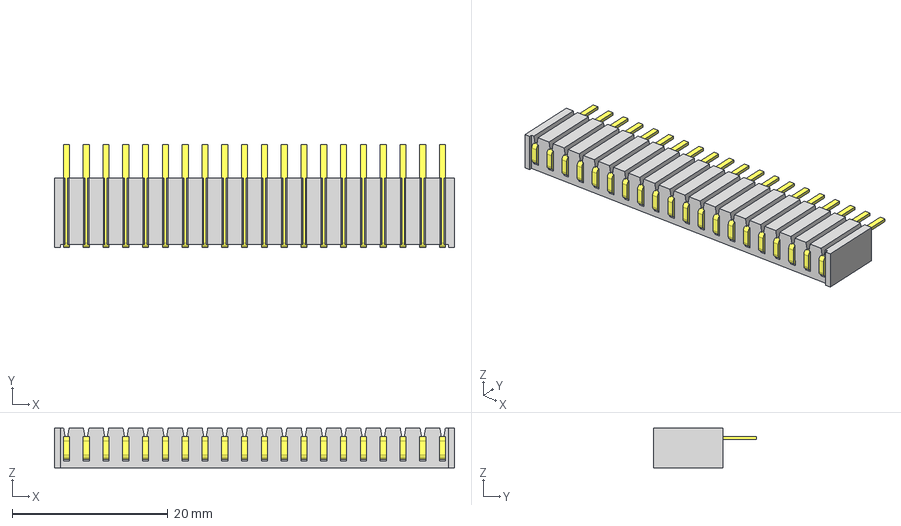
[picture p18: CAD file, 2023-11-03]
Footprints/BSW-120-X-X-S/BSW-120-X-X-S.step
51.3 x 13.2 x 5.08 mm
C-8-5-01-20-S
BSW-20-04-S_socket
