lleck/PercussiveInterface-3/Footprints/BSW-134-X-X-S/BSW-134-X-X-S.step

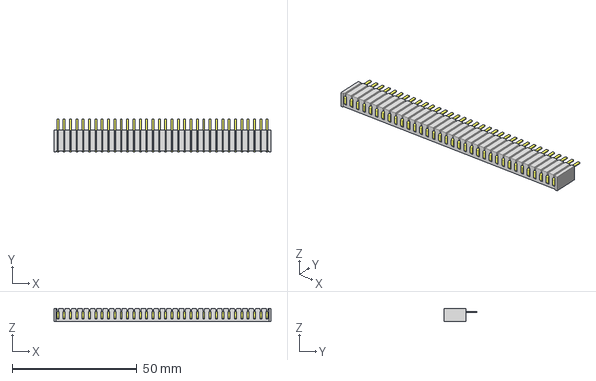
[picture p19: CAD file, 2023-11-03]
Footprints/BSW-134-X-X-S/BSW-134-X-X-S.step
86.9 x 13.2 x 5.08 mm
C-8-5-01-34-S
BSW-34-04-S_socket
