lleck/PercussiveInterface-3/Footprints/ESP32-S3-WROOM-1-N16R2/ESP32-S3-WROOM-1-N16R2.step

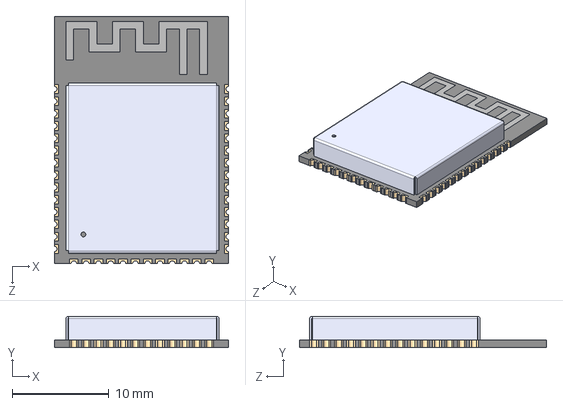
[picture p20: CAD file, 2023-11-09]
Footprints/ESP32-S3-WROOM-1-N16R2/ESP32-S3-WROOM-1-N16R2.step
18.0 x 3.25 x 25.5 mm
