lleck/PercussiveInterface-3/Footprints/Models/mill-max-0670-0-15-15-30-XX-10-0.step

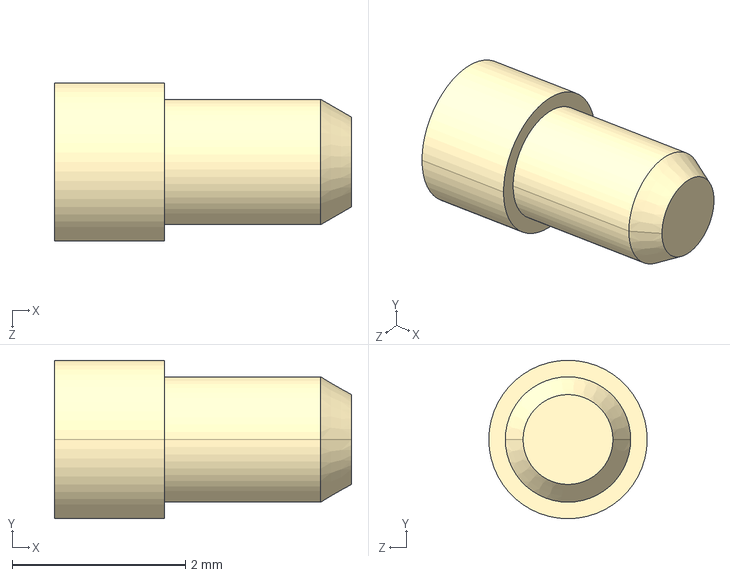
[picture p21: CAD file, 2023-11-14]
Footprints/Models/mill-max-0670-0-15-15-30-XX-10-0.step
3.43 x 1.83 x 1.83 mm
