lleck/PercussiveInterface-3/Footprints/Models/ul_TXU0304RUTR/RUT0012A.stp

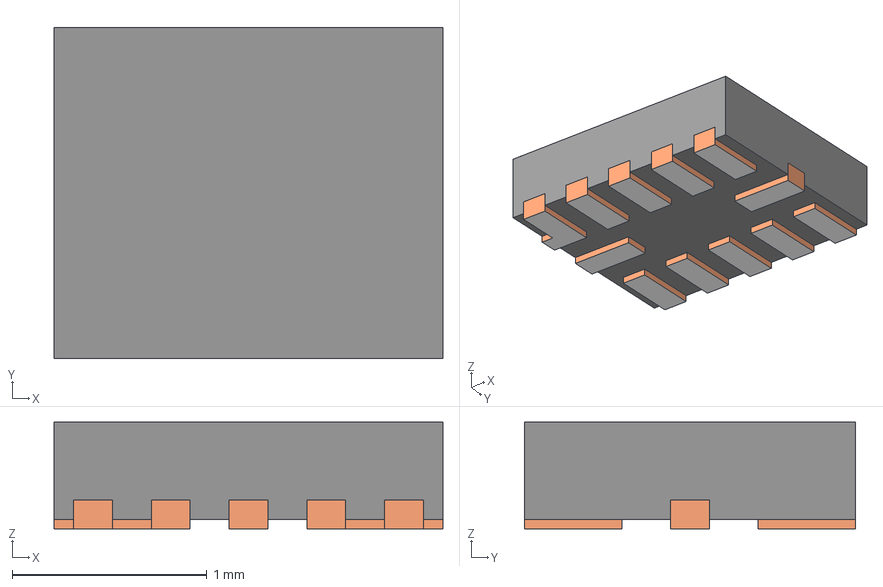
[picture p22: CAD file, 2023-11-15]
Footprints/Models/ul_TXU0304RUTR/RUT0012A.stp
2.00 x 1.70 x 0.55 mm
BODY-SON
FRAME-RUT0012A
PIN1-ID
