lleck/PercussiveInterface-3/Footprints/SAMTEC-SLW-105-01-X-S/SAMTEC-SLW-105-01-X-S.step

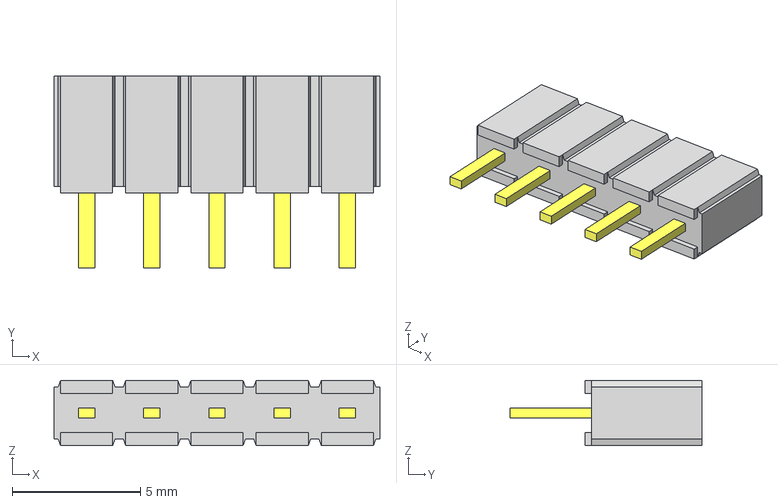
[picture p23: CAD file, 2023-11-03]
Footprints/SAMTEC-SLW-105-01-X-S/SAMTEC-SLW-105-01-X-S.step
12.7 x 7.49 x 2.54 mm
C-28-01-05-S
SLW-105-01-S_socket
