lleck/PercussiveInterface-3/Footprints/SAMTEC-SLW-108-01-X-S/SAMTEC-SLW-108-01-X-S.step

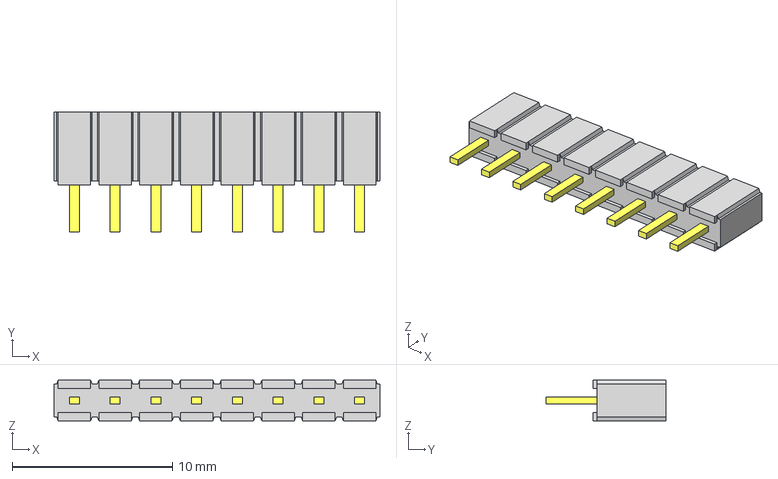
[picture p24: CAD file, 2023-11-03]
Footprints/SAMTEC-SLW-108-01-X-S/SAMTEC-SLW-108-01-X-S.step
20.3 x 7.49 x 2.54 mm
C-28-01-08-S
SLW-108-01-S_socket
