lleck/PercussiveInterface-3/Footprints/SAMTEC-SLW-112-01-T-S/SAMTEC-SLW-112-01-X-S.step

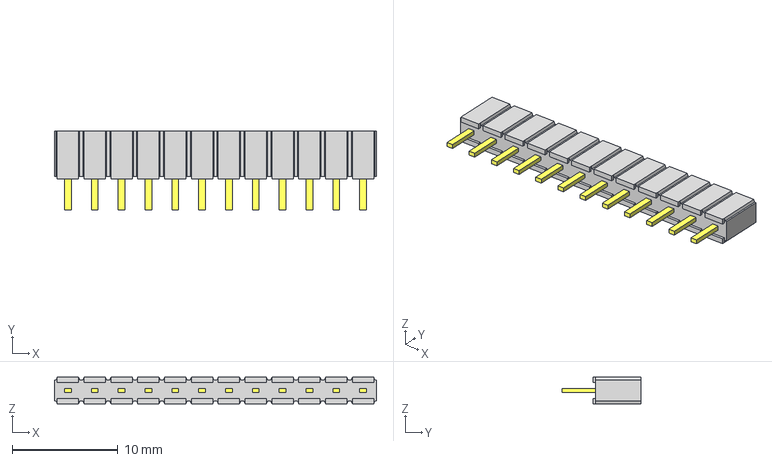
[picture p25: CAD file, 2023-11-03]
Footprints/SAMTEC-SLW-112-01-T-S/SAMTEC-SLW-112-01-X-S.step
30.5 x 7.49 x 2.54 mm
C-28-01-12-S
SLW-112-01-S_socket
