lleck/PercussiveInterface-3/Footprints/SAMTEC-TSM-105-04-T-SH-TR/TSM-105-04-T-SH.step

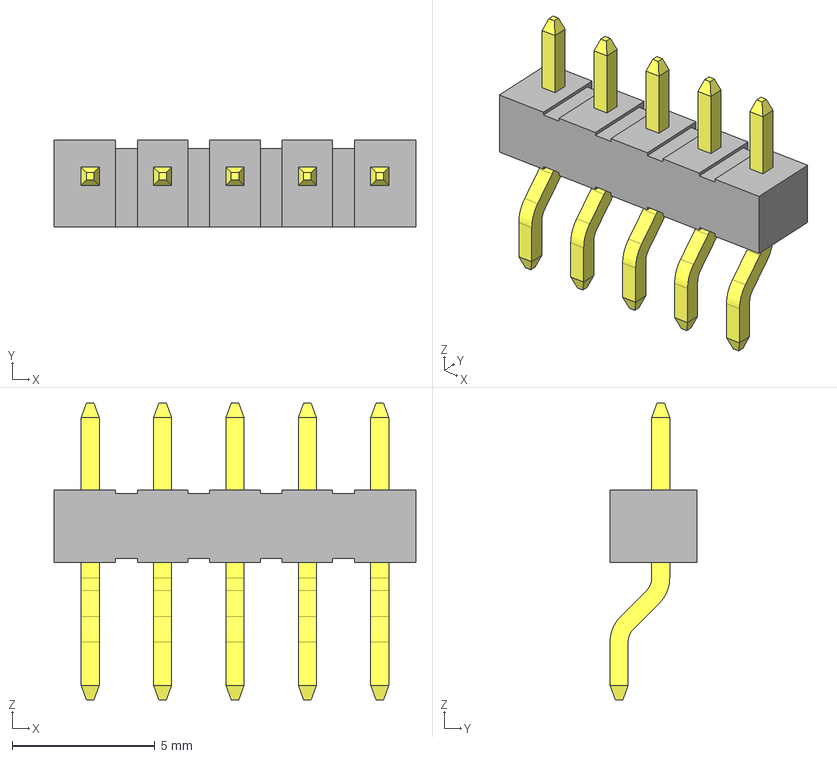
[picture p26: CAD file, 2023-11-03]
Footprints/SAMTEC-TSM-105-04-T-SH-TR/TSM-105-04-T-SH.step
12.7 x 3.05 x 10.4 mm
T-1S6-07(-04-5-SH)
TSM-105-04-SH_body
