lleck/PercussiveInterface-3/Footprints/SAMTEC-TSM-112-04-T-SH/TSM-112-04-T-SH.step

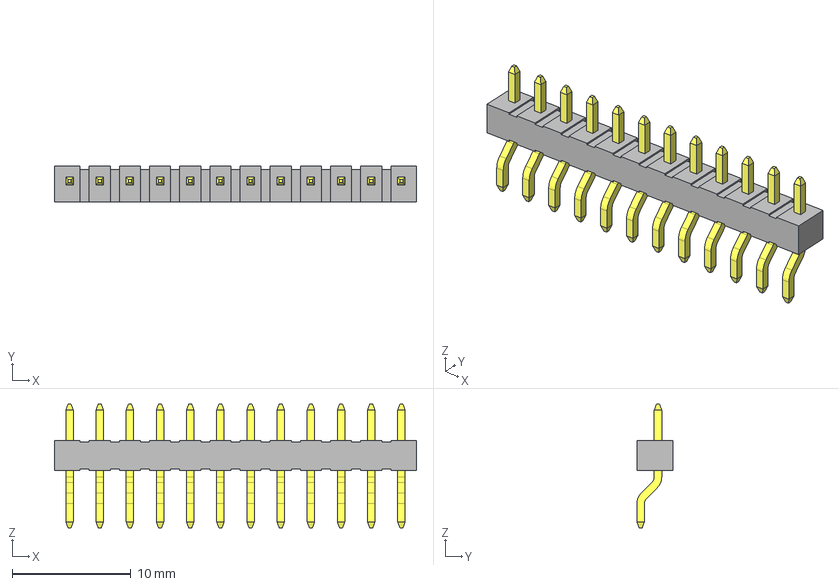
[picture p27: CAD file, 2023-11-03]
Footprints/SAMTEC-TSM-112-04-T-SH/TSM-112-04-T-SH.step
30.5 x 3.05 x 10.4 mm
T-1S6-07(-04-12-SH)
TSM-112-04-SH_body
