lleck/PercussiveInterface-3/Footprints/SLW-104-01-G-S/SLW-104-01-G-S.step

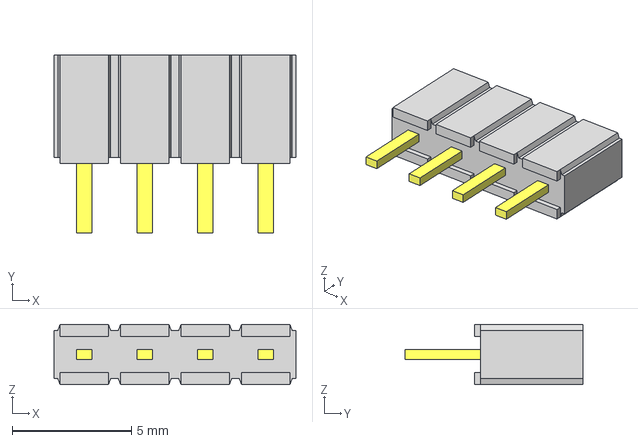
[picture p28: CAD file, 2023-11-03]
Footprints/SLW-104-01-G-S/SLW-104-01-G-S.step
10.2 x 7.49 x 2.54 mm
C-28-01-04-S
SLW-104-01-S_socket
