lleck/PercussiveInterface-3/ldc1101-click-2d-and-3d-files-v100/LDC 1101_click_v100.step

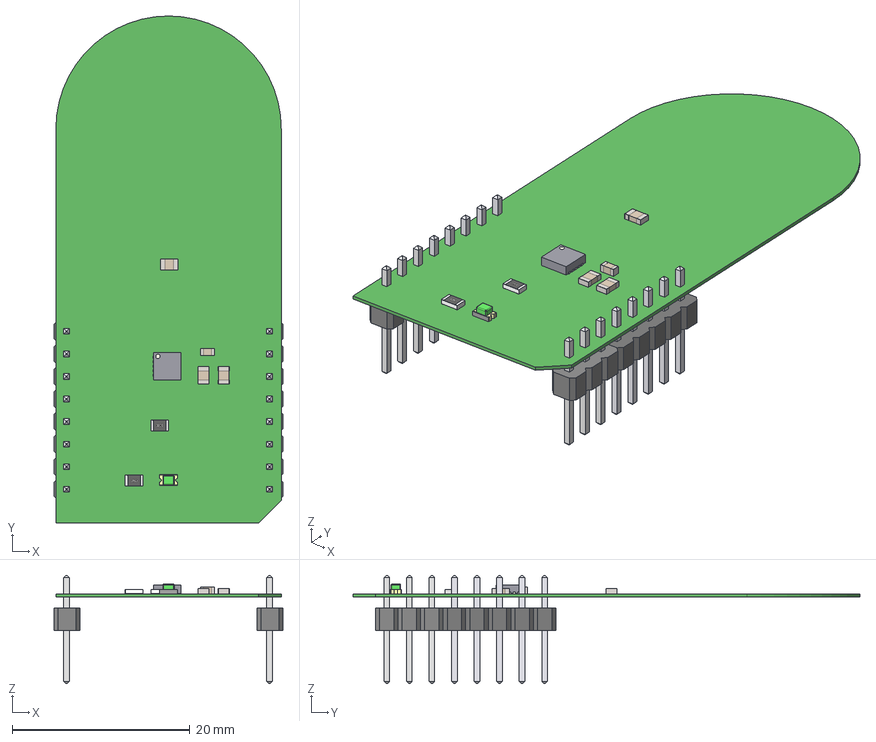
[picture p29: CAD file, 2023-11-06]
ldc1101-click-2d-and-3d-files-v100/LDC 1101_click_v100.step
25.8 x 57.1 x 12.2 mm
Board
User_Library-R_0805 x 2
Extruded x 12
User_Library-PinHeaderX3_PinHeader_Body_1 x 2
User_Library-PinHeaderX3_PinHeader_Pins_1 x 2
User_Library-PinHeaderX5-1_PinHeaderX5_Pins_1 x 2
User_Library-PinHeaderX5-1_PinHeaderX5_Body_1 x 2
led_0805_green
User_Library-SMD_CAPACITOR0805 x 3
User_Library-SMD_CAPACITOR0603
