lleck/PercussiveInterface-3/percussiveInterface-3.2/apa102_led_array/apa102_led_array/apa102_led_array.step

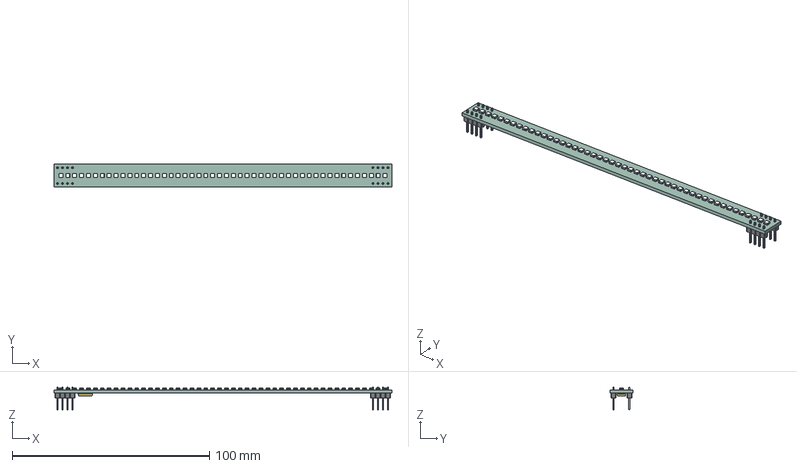
[picture p30: CAD file, 2023-11-06]
percussiveInterface-3.2/apa102_led_array/apa102_led_array/apa102_led_array.step
171.5 x 11.5 x 11.5 mm
apa102_led_array PCB
