lleck/PercussiveInterface-3/percussiveInterface-3.2/magnetometer_array_2/magnetometer_array_2.step

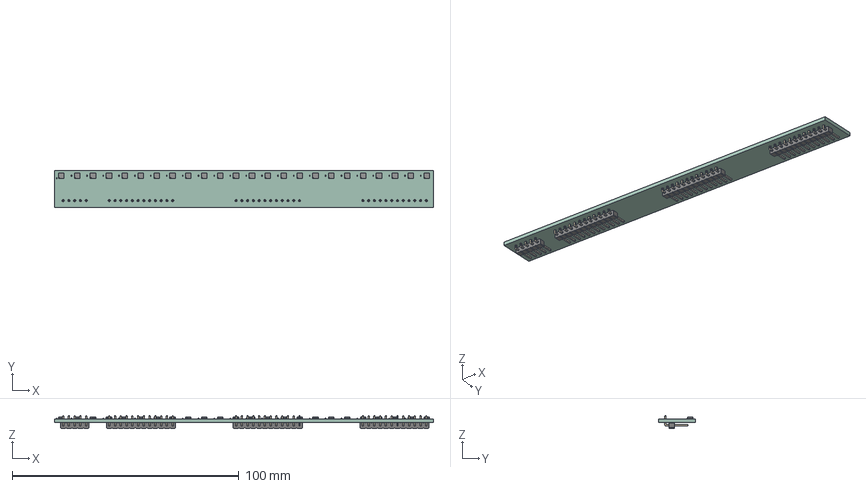
[picture p31: CAD file, 2023-11-03]
percussiveInterface-3.2/magnetometer_array_2/magnetometer_array_2.step
167.0 x 16.5 x 5.54 mm
magnetometer_array_2 PCB
