lleck/PercussiveInterface-3/percussiveInterface-3.2/magnetometer_array_3/magnetometer_array_3.step

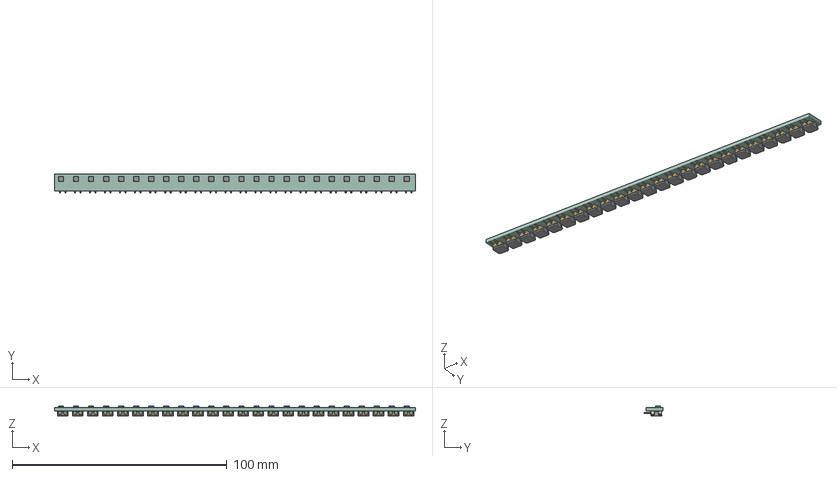
[picture p32: CAD file, 2023-11-15]
percussiveInterface-3.2/magnetometer_array_3/magnetometer_array_3.step
168.0 x 9.04 x 4.85 mm
_autosave-magnetometer_array_3 PCB
