lleck/PercussiveInterface-3/StepFiles_Drum/1410lugdiecasthoops.step

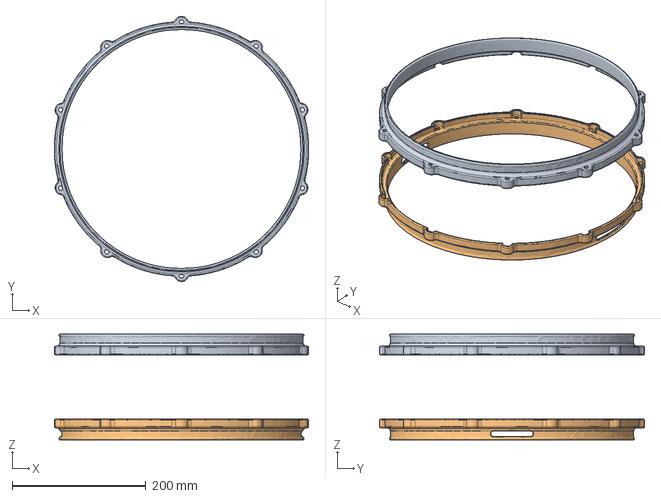
[picture p33: CAD file, 2023-12-01]
StepFiles_Drum/1410lugdiecasthoops.step
380.9 x 396.9 x 158.3 mm
