lleck/PercussiveInterface-3/Footprints/Models/mill-max-328-10-102-40-020001.STEP

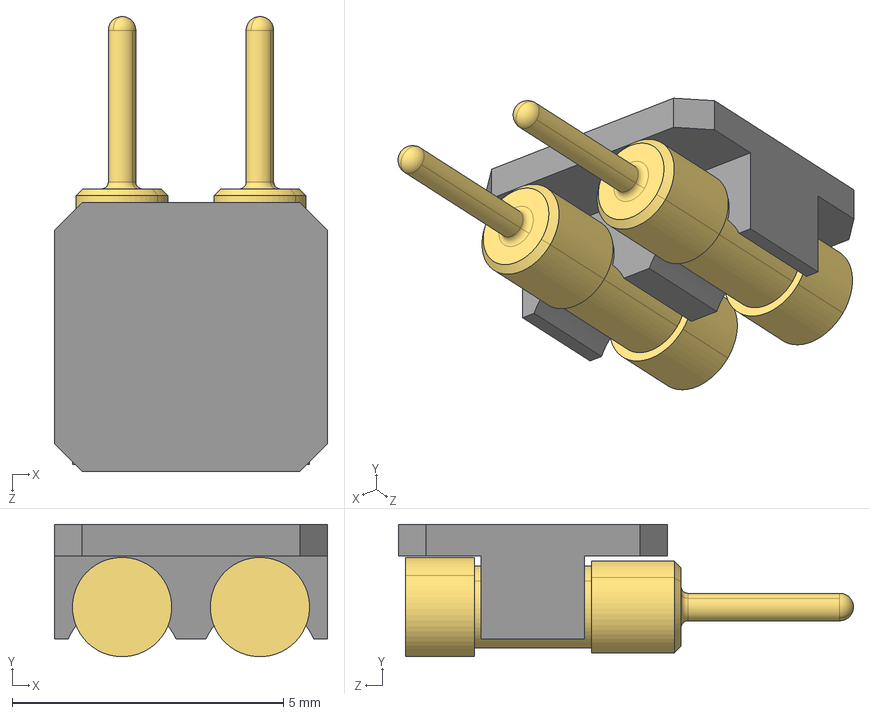
[picture p34: CAD file, 2023-11-14]
Footprints/Models/mill-max-328-10-102-40-020001.STEP
5.03 x 2.44 x 8.38 mm
P8XX-18-083-00-400155_P802-18-083-00-400155
2820-X_2820-0-00-15-00-00-03-0 x 2
