lleck/PercussiveInterface-3/StepFiles_Drum/pulley_gt2_90t.stl

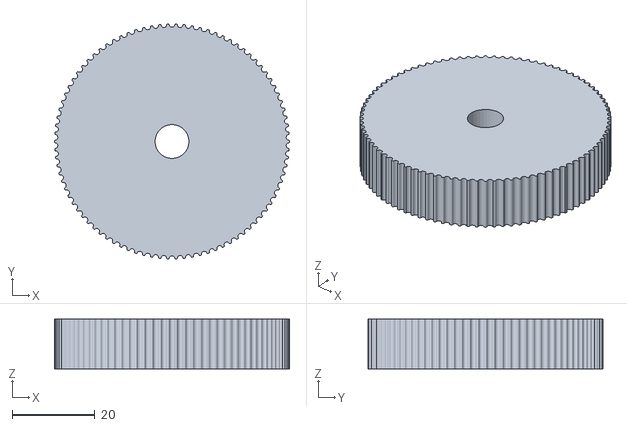
[picture p35: CAD file, 2023-11-23]
StepFiles_Drum/pulley_gt2_90t.stl
56.8 x 56.8 x 12.0
