lleck/PercussiveInterface-3/Stick_Head_V2.stl

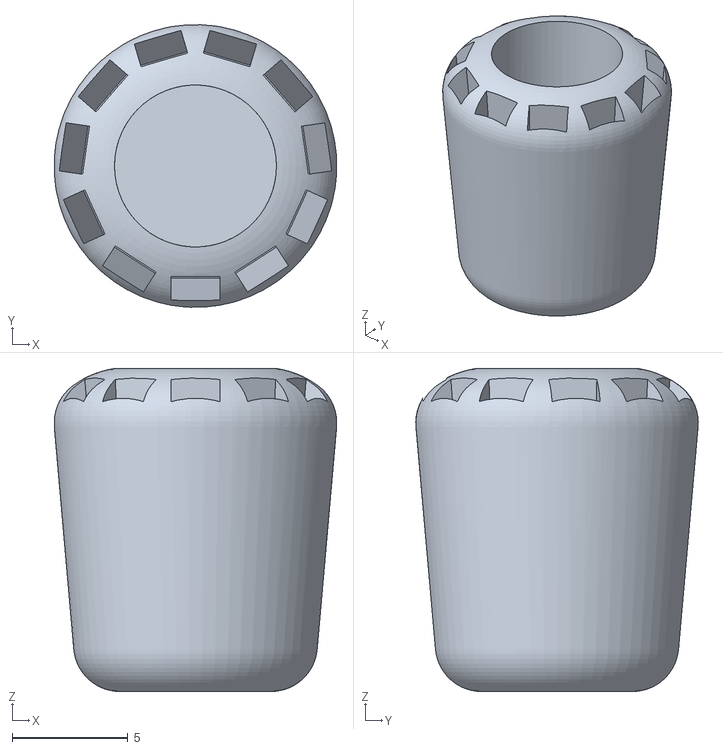
[picture p36: CAD file, 2023-12-29]
Stick_Head_V2.stl
12.2 x 12.2 x 14.0
