lleck/PercussiveInterface-3/Footprints/Models/mill-max-0558-0-15-15-30-XX-10-0.step

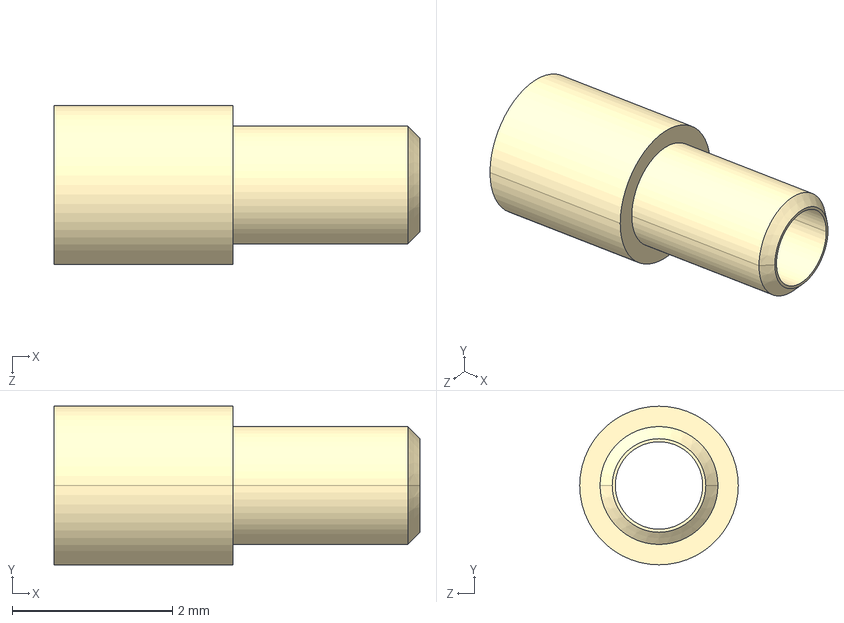
[picture p37: CAD file, 2023-11-14]
Footprints/Models/mill-max-0558-0-15-15-30-XX-10-0.step
4.57 x 1.98 x 1.98 mm
