lleck/PercussiveInterface-3/StepFiles_Drum/UCFL-203.STEP

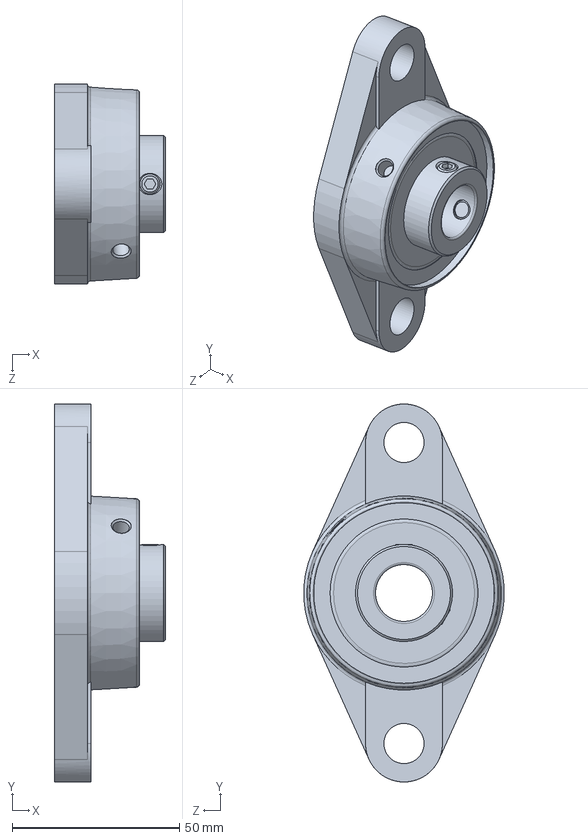
[picture p38: CAD file, 2023-11-23]
StepFiles_Drum/UCFL-203.STEP
33.3 x 113.0 x 59.9 mm
