lleck/PercussiveInterface-3/Footprints/Models/mill-max-3907-0-18-01-30-XX-10-0.step

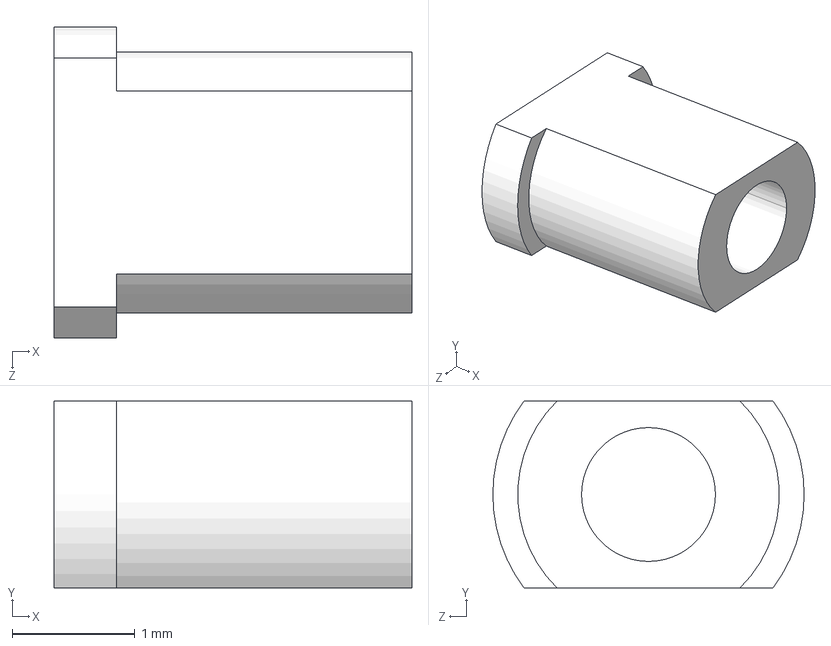
[picture p39: CAD file, 2023-11-13]
Footprints/Models/mill-max-3907-0-18-01-30-XX-10-0.step
2.92 x 1.52 x 2.54 mm
