lleck/PercussiveInterface-3/StepFiles_Drum/XD-3420_12V-3500RPM_Motor.STEP

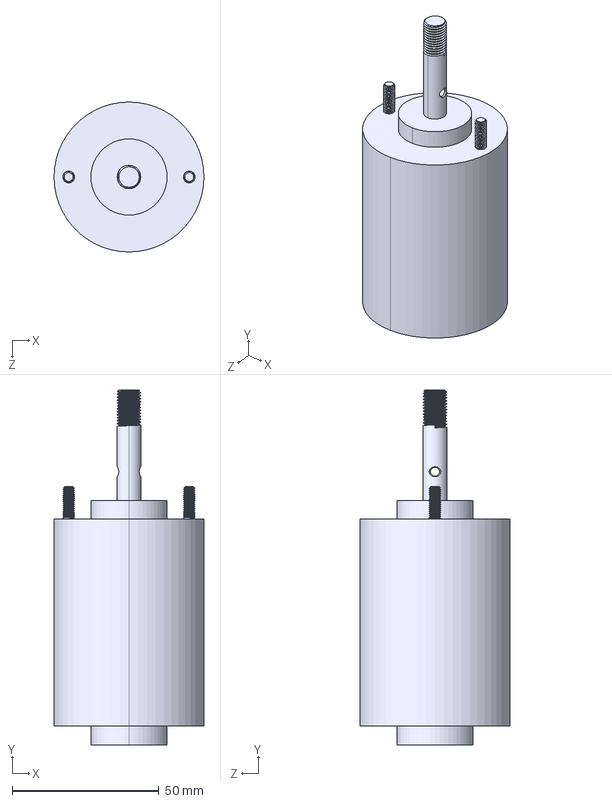
[picture p40: CAD file, 2023-11-23]
StepFiles_Drum/XD-3420_12V-3500RPM_Motor.STEP
51.0 x 120.8 x 51.0 mm
