lleck/PercussiveInterface-3/receiver_coil_mount_part2.stl

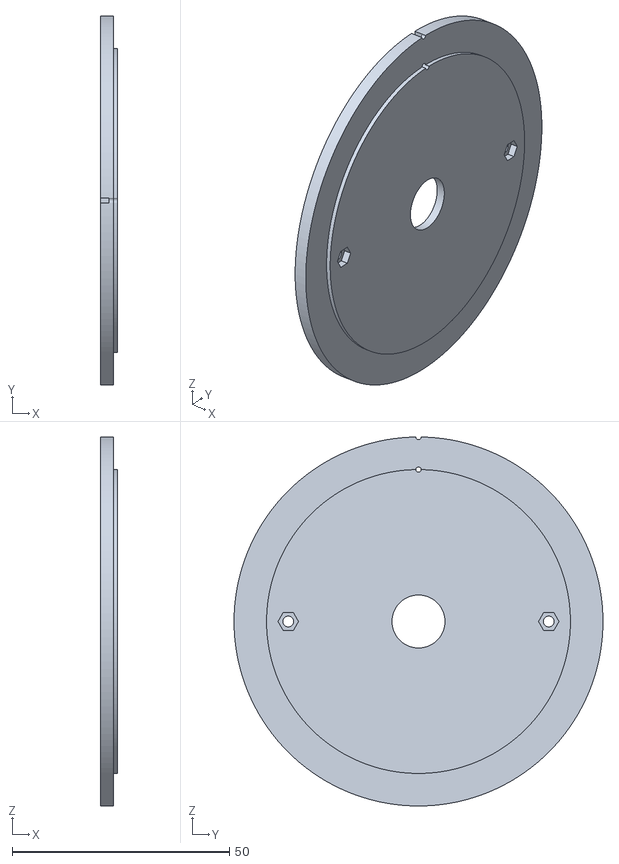
[picture p41: CAD file, 2023-12-14]
receiver_coil_mount_part2.stl
4.00 x 85.0 x 85.0
