lleck/PercussiveInterface-3/Shaft_Mount_Receiving_Coil.stl

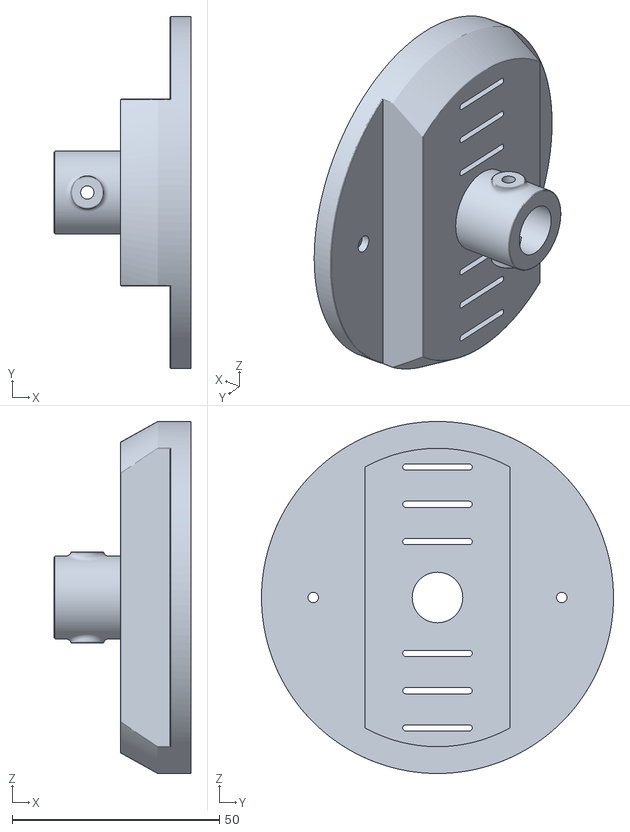
[picture p42: CAD file, 2023-12-14]
Shaft_Mount_Receiving_Coil.stl
33.0 x 85.0 x 85.0
