lleck/PercussiveInterface-3/percussiveInterface-3.step

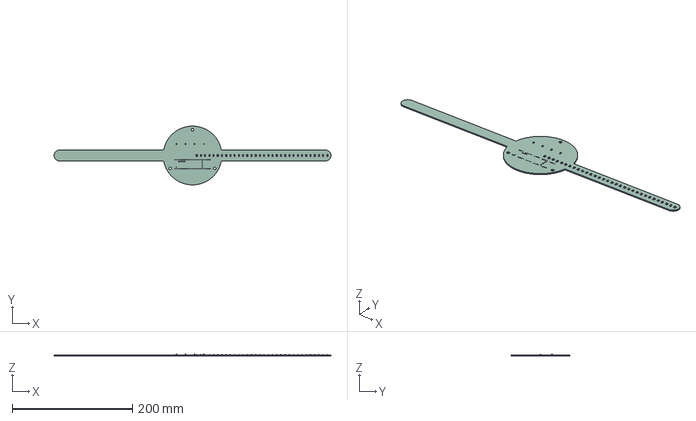
[picture p43: CAD file, 2023-05-05]
percussiveInterface-3.step
460.0 x 97.7 x 2.88 mm
PCB
