lleck/PercussiveInterface-3/Footprints/Models/APA102 2020 LED.step

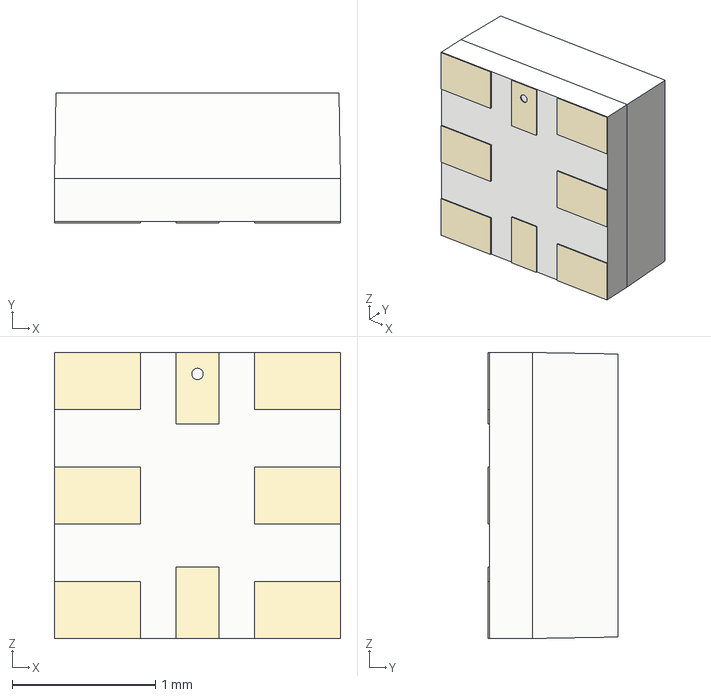
[picture p44: CAD file, 2023-11-03]
Footprints/Models/APA102 2020 LED.step
2.00 x 0.91 x 2.00 mm
