lleck/PercussiveInterface-3/Footprints/Models/MDF7-5S-2.54DSA.stp

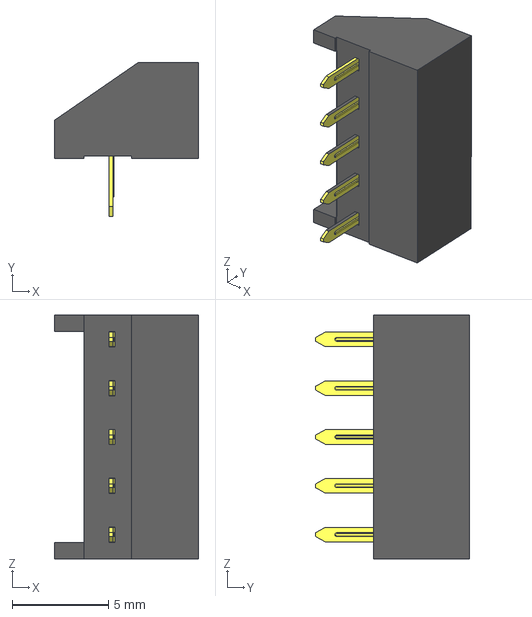
[picture p45: CAD file, 2023-10-31]
Footprints/Models/MDF7-5S-2.54DSA.stp
7.50 x 8.00 x 12.7 mm
