lleck/PercussiveInterface-3/Footprints/Models/MDF7-12S-2.54DSA(55)--3DModel-STEP-1.STEP

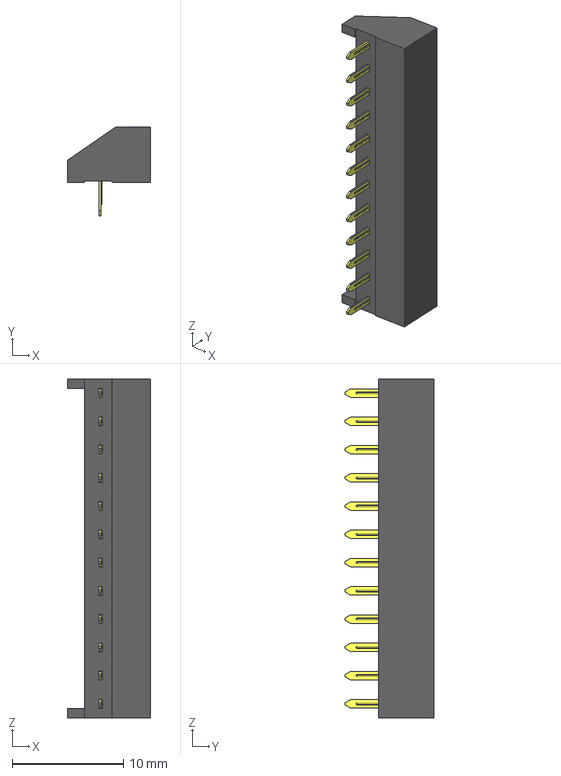
[picture p46: CAD file, 2023-10-31]
Footprints/Models/MDF7-12S-2.54DSA(55)--3DModel-STEP-1.STEP
7.50 x 8.00 x 30.5 mm
