lleck/PercussiveInterface-3/(list of files, cad)

Other CAD files:
Footprints/Models/BSW-134-04-L-S.stp
Stick_Head_V1.stl
nut_job_20160828-21486-ti2m8a-0.stl
