lleck/PercussiveInterface-3/grove_LDC/202002176_PCBA;Grove - 2-Channel Inductive Sensor (LDC1612)_原理图/Grove - 2 Channel Inductive Sensor（LDC1612).pdf

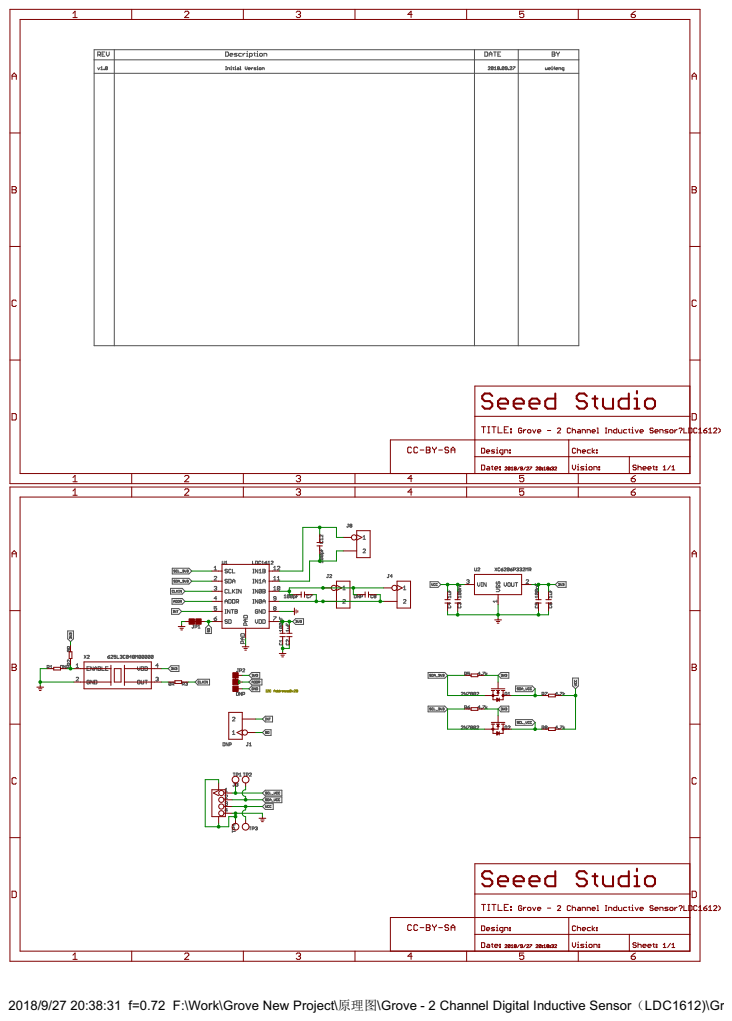
[picture p47: page 1]

2018/9/27 20:38:31 f=0.72 F:\Work\Grove New Project\原理图\Grove - 2 Channel Digital Inductive Sensor（LDC1612)\Grove - 2 Channel Digital Inductive Sensor（LDC1612)\NPI\1\202002176_PCBA;Grove - 2-Channel Inductive Sensor (LDC1612)_原理图\Grove - 2 Channel Inductive Sensor（LDC1612).sch (Sheet: 1/1)
