lleck/PercussiveInterface-3/(list of files, drawings)

Other design files:
percussiveInterface-3.2/magnetometer_array_2/freerouting.dsn
percussiveInterface-3.2/magnetometer_array_2/temp-freerouting.dsn
