lleck/PercussiveInterface-3/grove_LDC/ldc_grove/ldc_grove.kicad_pcb

## KiCad design MCU.kicad_sch

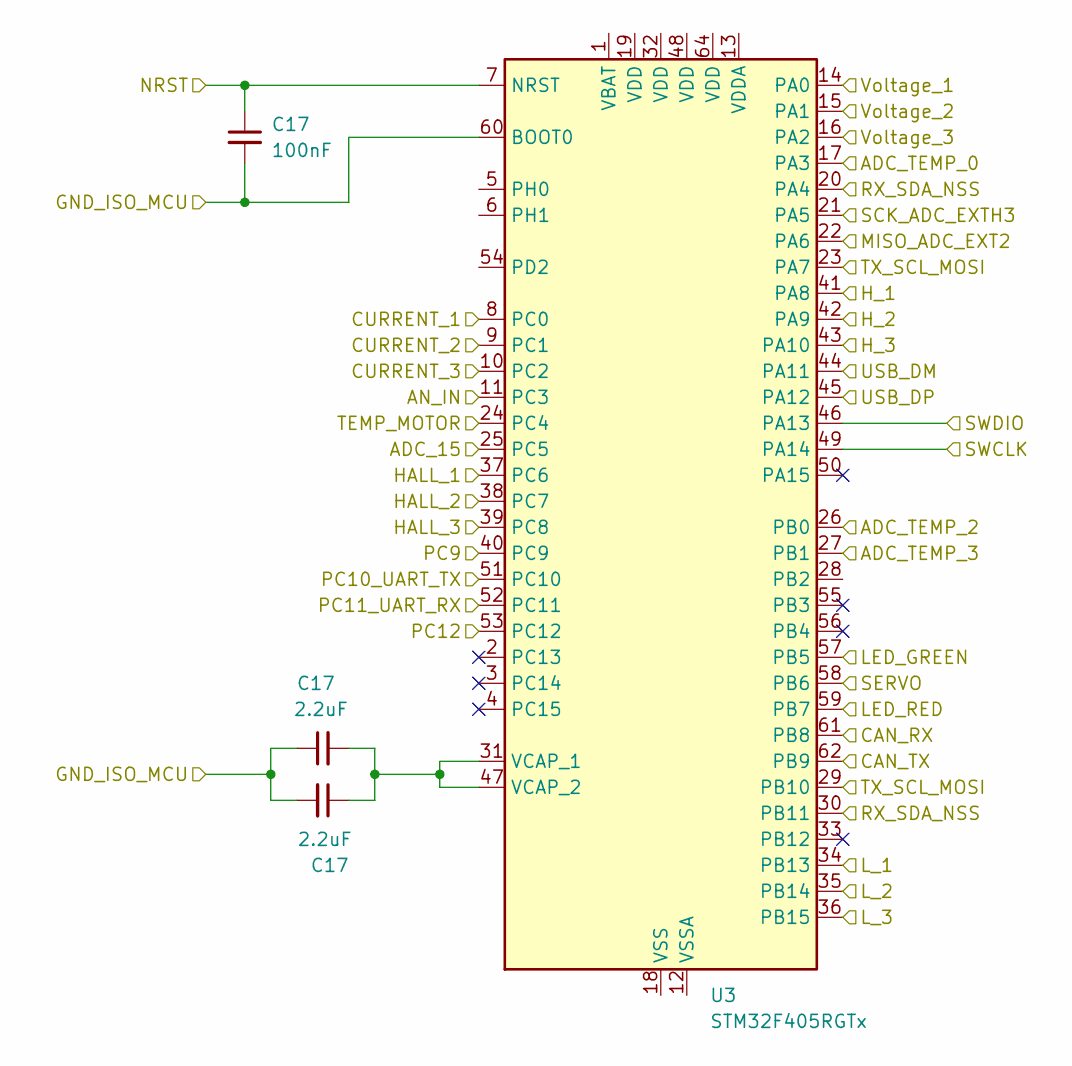
[picture p48: schematic MCU.kicad_sch]

Parts:
C17: 100nF; Voltage V 100
U3: STM32F405RGTx; LQFP-64_10x10mm_P0.5mm

Connections:
ADC_15: U3.25 (PC5)
ADC_TEMP_0: U3.17 (PA3)
ADC_TEMP_2: U3.26 (PB0)
ADC_TEMP_3: U3.27 (PB1)
AN_IN: U3.11 (PC3)
CAN_RX: U3.61 (PB8)
CAN_TX: U3.62 (PB9)
CURRENT_1: U3.8 (PC0)
CURRENT_2: U3.9 (PC1)
CURRENT_3: U3.10 (PC2)
GND_ISO_MCU: C17.1, C17.2, U3.60 (BOOT0)
HALL_1: U3.37 (PC6)
HALL_2: U3.38 (PC7)
HALL_3: U3.39 (PC8)
H_1: U3.41 (PA8)
H_2: U3.42 (PA9)
H_3: U3.43 (PA10)
LED_GREEN: U3.57 (PB5)
LED_RED: U3.59 (PB7)
L_1: U3.34 (PB13)
L_2: U3.35 (PB14)
L_3: U3.36 (PB15)
MISO_ADC_EXT2: U3.22 (PA6)
NRST: C17.1, U3.7 (NRST)
unnamed: C17.1, C17.2, U3.31 (VCAP_1), U3.47 (VCAP_2)
unnamed: U3.18 (VSS), U3.63 (VSS)
PC9: U3.40 (PC9)
PC10_UART_TX: U3.51 (PC10)
PC11_UART_RX: U3.52 (PC11)
PC12: U3.53 (PC12)
RX_SDA_NSS: U3.20 (PA4), U3.30 (PB11)
SCK_ADC_EXTH3: U3.21 (PA5)
SERVO: U3.58 (PB6)
SWCLK: U3.49 (PA14)
SWDIO: U3.46 (PA13)
TEMP_MOTOR: U3.24 (PC4)
TX_SCL_MOSI: U3.23 (PA7), U3.29 (PB10)
USB_DM: U3.44 (PA11)
USB_DP: U3.45 (PA12)
Voltage_1: U3.14 (PA0)
Voltage_2: U3.15 (PA1)
Voltage_3: U3.16 (PA2)
