lleck/PercussiveInterface-3/grove_LDC/ldc_grove/ldc_grove.kicad_pcb

## KiCad design Power.kicad_sch

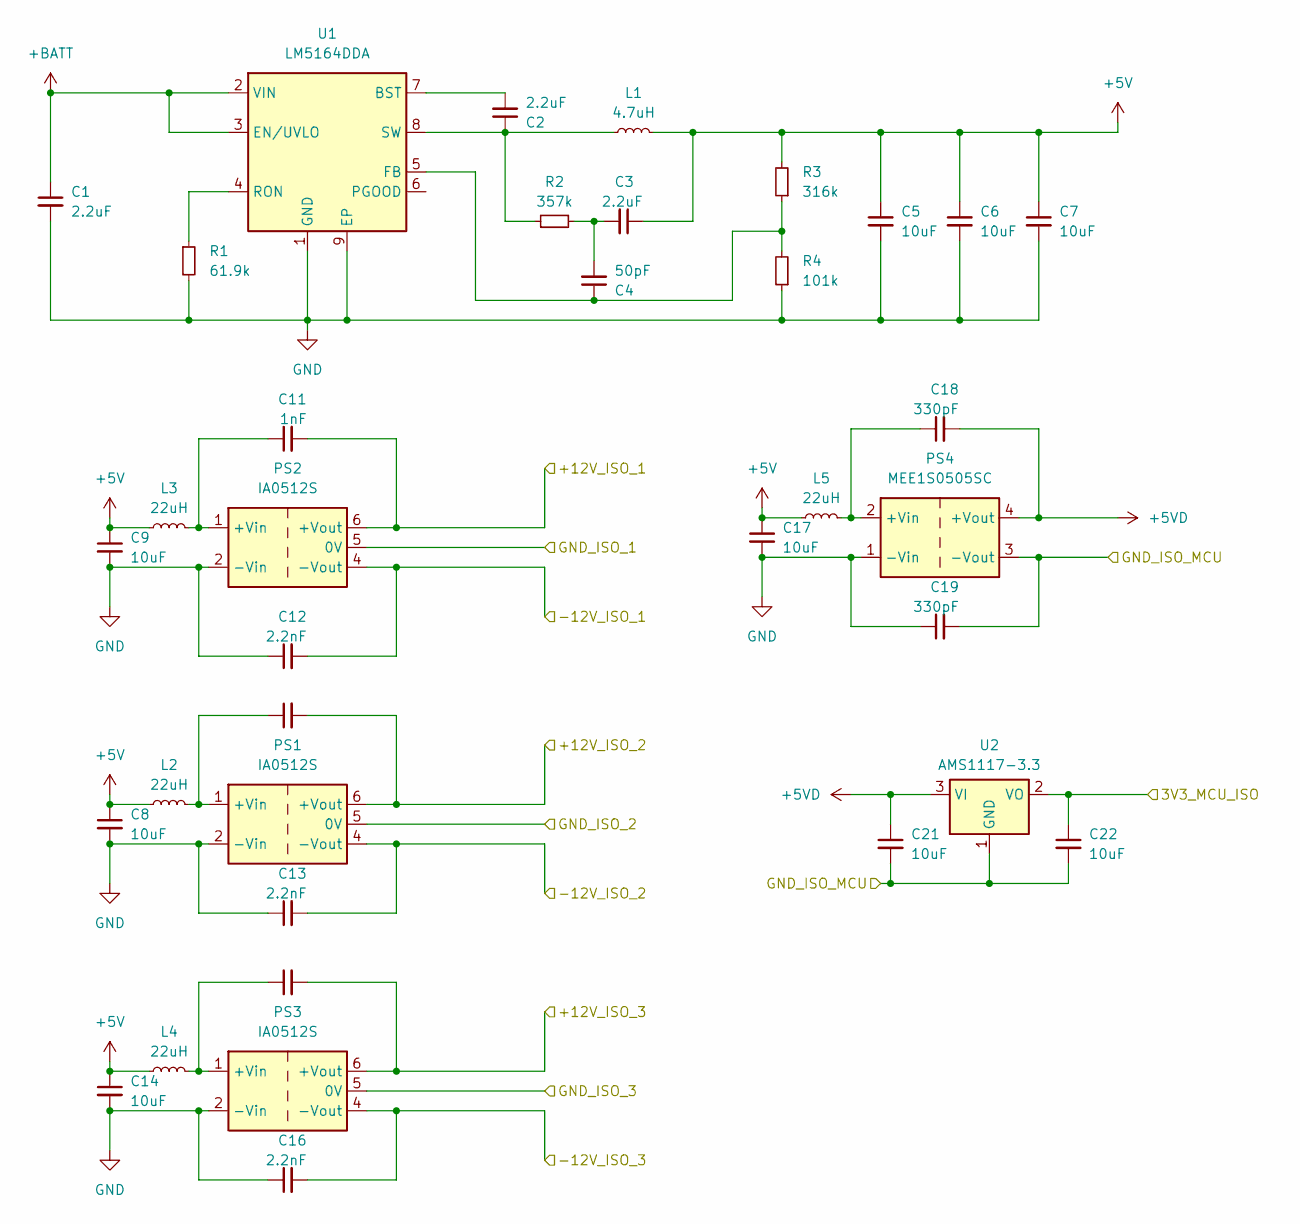
[picture p49: schematic Power.kicad_sch]

Parts:
C1, C2, C3: 2.2uF; Voltage V +100
C4: 50pF; Voltage V +100
C5, C6, C7: 10uF; Voltage V +50
C8, C9, C14, C17, C21, C22: 10uF; Voltage V 100
C10, C11, C15: 1nF; Voltage V +50
C12, C13, C16: 2.2nF; Voltage V +50
C18, C19: 330pF; Voltage V +50
L1: 4.7uH
L2, L3, L4, L5: 22uH
PS1, PS2, PS3: IA0512S; Converter_DCDC_XP_POWER-IAxxxxS_THT
PS4: MEE1S0505SC; Converter_DCDC_Murata_MEE1SxxxxSC_THT
R1: 61.9k
R2: 357k
R3: 316k
R4: 101k
U1: LM5164DDA; HSOP-8-1EP_3.9x4.9mm_P1.27mm_EP2.41x3.1mm_ThermalVias
U2: AMS1117-3.3; SOT-223-3_TabPin2

Connections:
3V3_MCU_ISO: C22.1, U2.2 (VO)
+5V: C3.1, C5.1, C6.1, C7.1, C8.1, C9.1, C14.1, C17.1, L1.2, L2.1, L3.1, L4.1, L5.1, R3.2
+5VD: C18.2, C21.1, PS4.4 (+Vout), U2.3 (VI)
+12V_ISO_1: C11.2, PS2.6 (+Vout)
+12V_ISO_2: C10.2, PS1.6 (+Vout)
+12V_ISO_3: C15.2, PS3.6 (+Vout)
+BATT: C1.1, U1.2 (VIN), U1.3 (EN/UVLO)
-12V_ISO_1: C12.2, PS2.4 (-Vout)
-12V_ISO_2: C13.2, PS1.4 (-Vout)
-12V_ISO_3: C16.2, PS3.4 (-Vout)
GND: C1.2, C5.2, C6.2, C7.2, C8.2, C9.2, C12.1, C13.1, C14.2, C16.1, C17.2, C19.1, PS1.2 (-Vin), PS2.2 (-Vin), PS3.2 (-Vin), PS4.1 (-Vin), R1.2, R4.1, U1.1 (GND), U1.9 (EP)
GND_ISO_1: PS2.5 (0V)
GND_ISO_2: PS1.5 (0V)
GND_ISO_3: PS3.5 (0V)
GND_ISO_MCU: C19.2, C21.2, C22.2, PS4.3 (-Vout), U2.1 (GND)
unnamed: C2.1, L1.1, R2.1, U1.8 (SW)
unnamed: C2.2, U1.7 (BST)
unnamed: C3.2, C4.2, R2.2
unnamed: C4.1, R3.1, R4.2, U1.5 (FB)
unnamed: C10.1, L2.2, PS1.1 (+Vin)
unnamed: C11.1, L3.2, PS2.1 (+Vin)
unnamed: C15.1, L4.2, PS3.1 (+Vin)
unnamed: C18.1, L5.2, PS4.2 (+Vin)
unnamed: R1.1, U1.4 (RON)
