lleck/PercussiveInterface-3/grove_LDC/202002176_PCBA;Grove - 2-Channel Inductive Sensor (LDC1612)_原理图/Grove - 2 Channel Inductive Sensor（LDC1612).brd

## EAGLE design grove_LDC/202002176_PCBA;Grove - 2-Channel Inductive Sensor (LDC1612)_原理图/Grove - 2 Channel Inductive Sensor（LDC1612).brd (2023-11-19)

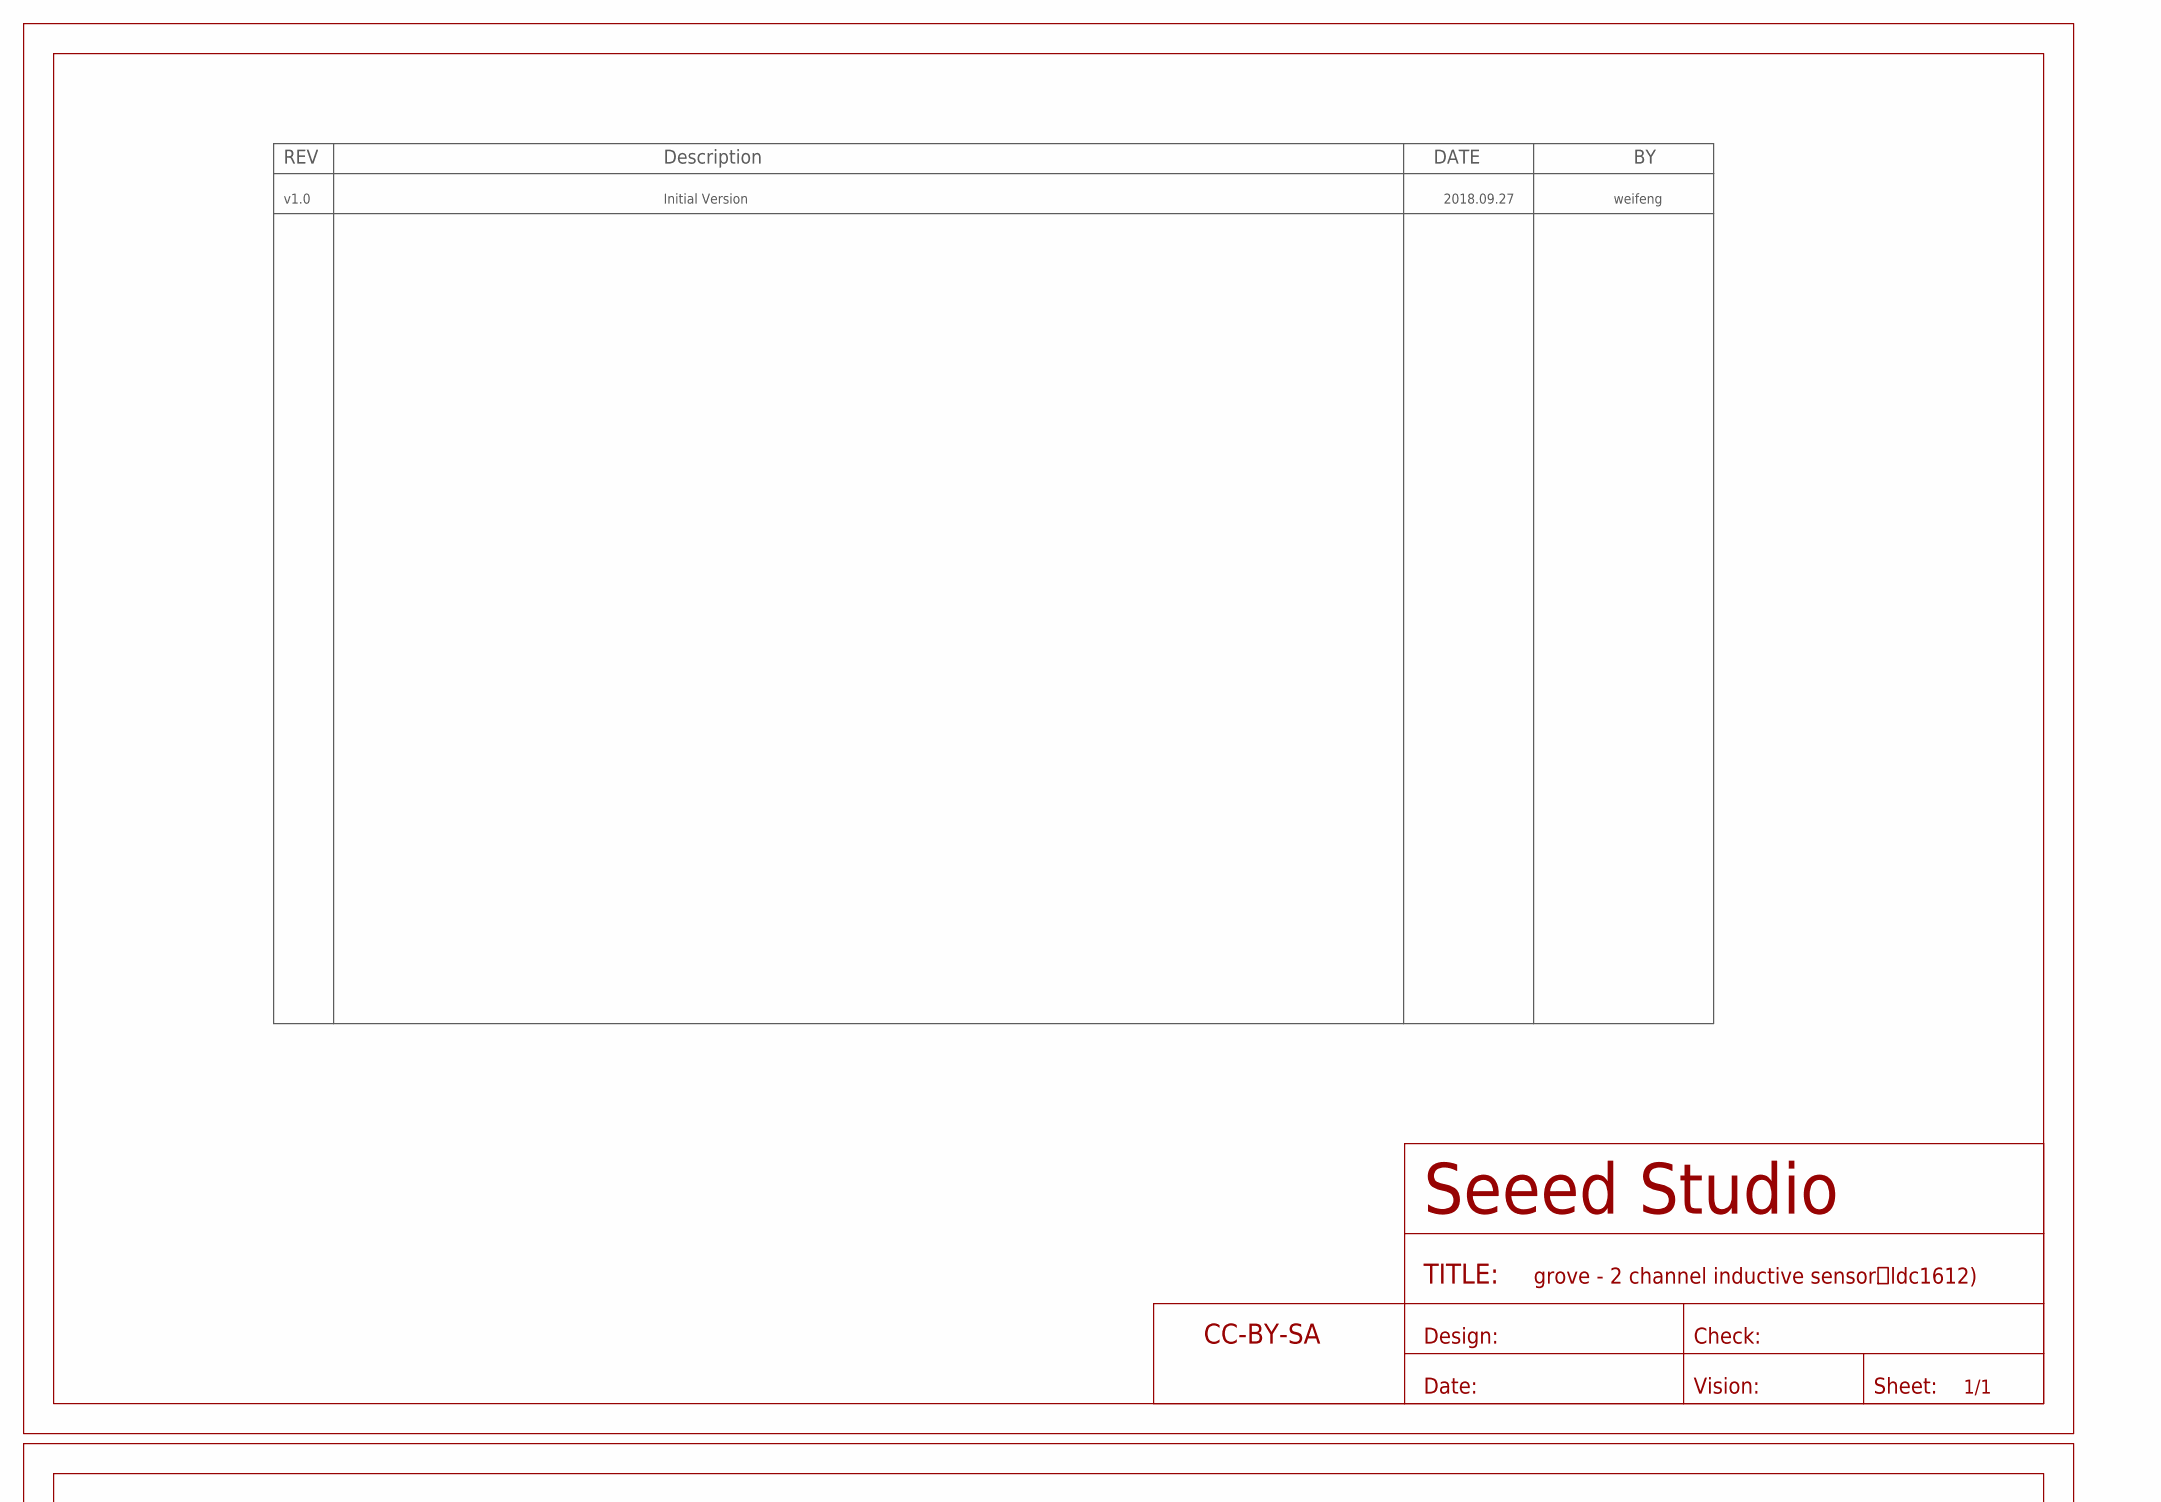
[picture p50: schematic Grove - 2 Channel Inductive Sensor（LDC1612).sch, part in row 1, column 1]

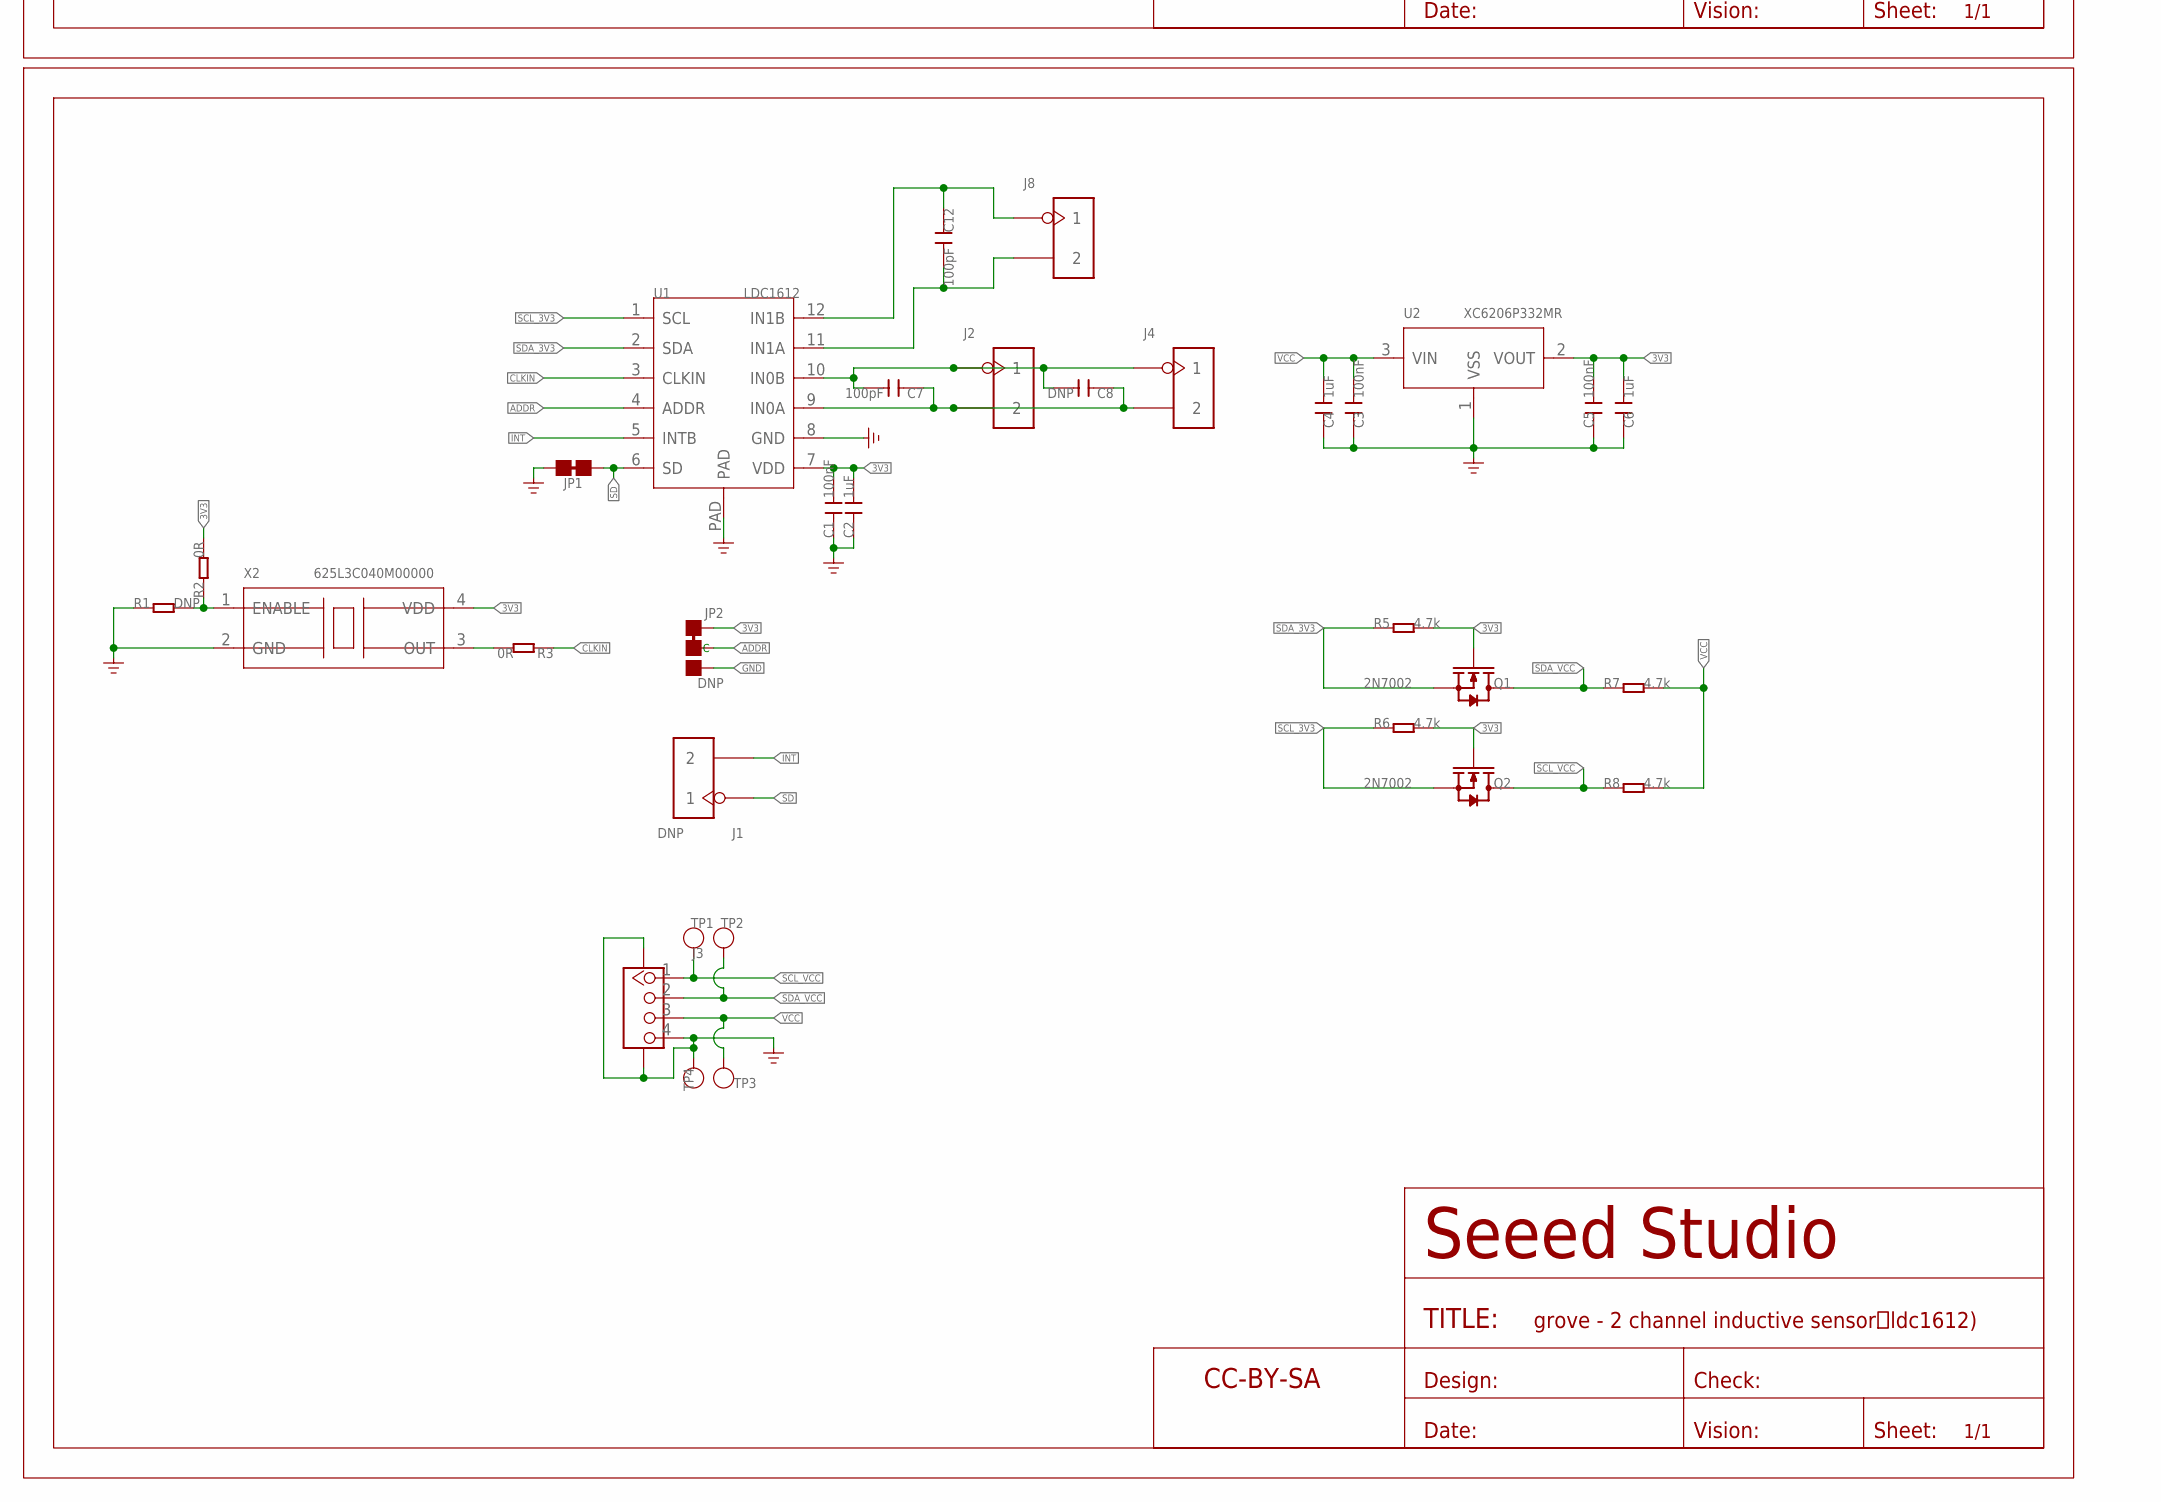
[picture p51: schematic Grove - 2 Channel Inductive Sensor（LDC1612).sch, part in row 2, column 1]

Parts:
C1, C3, C5: 100nF; C0603
C2, C4, C6: 1uF; C0603
C7, C12: 100pF; C0603
C8: DNP; C0603
FR1: SEEEDSTUDIO-OPEN-SCH-FRAME; SEEEDSTUDIO-PCB-FRAME
J1: DNP; H2-2.54
J2, J4, J8: HEADER-2P-65/35MIL; H2-2.54
J3: GROVE-CONNECTOR-SMD'DD'; HW4-SMD-2.0
JP1: JP-2P-SHORT; 2P-SMD-SHORT
JP2: DNP; 3P-SMD-SHORT
Q1, Q2: 2N7002; SOT-23
R1: DNP; R0603
R2, R3: 0R; R0603
R5, R6, R7, R8: 4.7k; R0603
TP1, TP2, TP3, TP4: TEST-POINT'4545'; TP-D45MIL
U1: LDC1612; DFN12G-0.5-4X4MM
U2: XC6206P332MR; SOT-23
U$4: SEEEDSTUDIO-OPEN-SCH-FRAME; SEEEDSTUDIO-PCB-FRAME
X2: 625L3C040M00000; OSC4-SMD-2.5X2.0X0.8MM

Connections:
3V3: C1.2, C2.2, C5.2, C6.2, JP2.11 (L), Q1.1 (G), Q2.1 (G), R2.2, R5.2, R6.2, U1.7 (VDD), U2.2 (VOUT), X2.4 (VDD)
ADDR: JP2.MM (C), U1.4 (ADDR)
CLKIN: R3.1, U1.3 (CLKIN)
GND: C1.1, C2.1, C3.1, C4.1, C5.1, C6.1, J3.4, J3.SS1, J3.SS2, JP1.1, JP2.00 (R), R1.1, TP4.T, U1.8 (GND), U1.PAD, U2.1 (VSS), X2.2 (GND)
INT: J1.2, U1.5 (INTB)
unnamed: R3.2, X2.3 (OUT)
unnamed: R1.2, R2.1, X2.1 (ENABLE)
unnamed: C7.1, C8.1, J2.2, J4.2, U1.9 (IN0A)
unnamed: C7.2, C8.2, J2.1, J4.1, U1.10 (IN0B)
unnamed: C12.1, J8.1, U1.12 (IN1B)
unnamed: C12.2, J8.2, U1.11 (IN1A)
SCL_3V3: Q2.2 (S), R6.1, U1.1 (SCL)
SCL_VCC: J3.1, Q2.3 (D), R8.1, TP1.T
SD: J1.1, JP1.2, U1.6 (SD)
SDA_3V3: Q1.2 (S), R5.1, U1.2 (SDA)
SDA_VCC: J3.2, Q1.3 (D), R7.1, TP2.T
VCC: C3.2, C4.2, J3.3, R7.2, R8.2, TP3.T, U2.3 (VIN)

Notes on the sheet:
v1.0
Initial Version
2018.09.27
weifeng

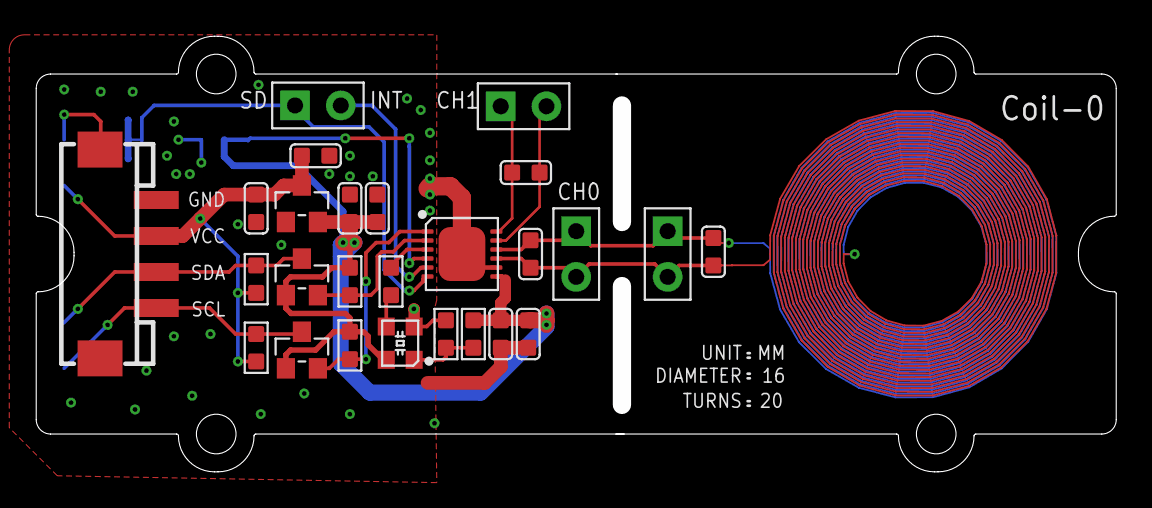
[picture p52: board Grove - 2 Channel Inductive Sensor（LDC1612).brd from above]

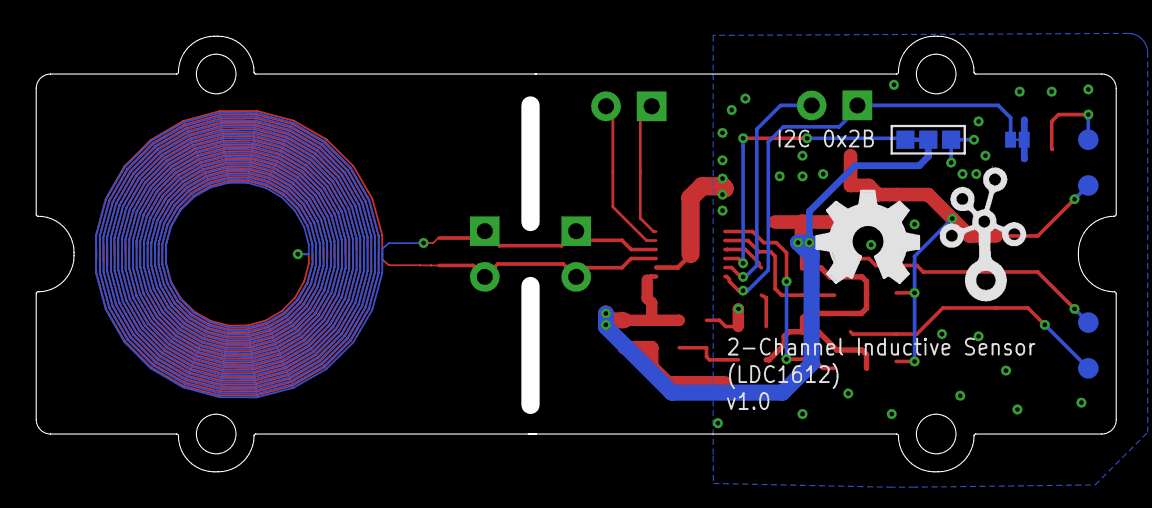
[picture p53: board Grove - 2 Channel Inductive Sensor（LDC1612).brd from below]

Board: 2 copper layers, 60.0 x 24.2 mm, 37 parts (8 on the bottom side), 17 nets.

Other parts of the board:
U$6: OSHW_FILLX200_NOTEXT
U$7: TWIGLOGO
U$14: GROVE-1*3-DRILL-DIM
