lleck/PercussiveInterface-3/(commit log)

2023-05-05 lleck
    first commit
    [Masterarbeit.csv, Masterarbeit.kicad_pcb, Masterarbeit.kicad_sch, Masterarbeit.step]
2023-05-09 conversion to 4layer
    inner ground and power layer and seperate outer layers for analog and
    digital signal routing
    [percussiveInterface-3.1.kicad_pcb]
2023-05-09 folder structure
    [percussiveInterface-3.1.kicad_pcb, percussiveInterface-3.1.kicad_sch, percussiveInterface-3.kicad_pcb, percussiveInterface-3.kicad_sch]
2023-05-09 small changes
    [percussiveInterface-3.1.kicad_pcb]
2023-05-25 analog read 3 hall sens Arduino Code 1st
2023-05-29 more notes
    [percussiveInterface-3.1.kicad_pcb]
2023-06-29 differential reading of hall sensors
2023-07-15 new layout 3.2
    [percussiveInterface-3.2.kicad_pcb, percussiveInterface-3.2.kicad_sch]
2023-07-15 layout 3.2
    [percussiveInterface-3.2.kicad_sch]
2023-07-15 nochmal update
    [percussiveInterface-3.2.kicad_sch]
2023-08-31 magnetometer array
2023-08-31 magnetometer arra<
    [magnetometer_array.kicad_pcb, magnetometer_array.kicad_sch]
2023-08-31 slightl<y new
    [magnetometer_array.kicad_pcb]
2023-09-28 coil plugin etc
    [Excel_FEMM_v1p29.xlsm, LDC_Tools-ext51.xlsx, coil_12_custom-2-layer.csv, coil_12_custom-4-layer.csv, coil_12_custom.csv, coil_12_spiral-2-layer.csv, coil_12_spiral-4-layer.csv, coil_12_spiral.csv]
2023-10-08 new magnetoarray
    [freerouting.dsn, magnetometer_array_2.kicad_pcb, magnetometer_array_2.kicad_sch, temp-freerouting.dsn]
2023-10-30 new arrray
    [apa102_led_array.kicad_pcb, apa102_led_array.kicad_sch, magnetometer_array_2.kicad_pcb, magnetometer_array_2.kicad_sch, magnetometer_array_2_old.kicad_pcb, percussiveInterface-3.2.kicad_sch]
2023-10-31 plentay stuffx
    [MDF7-12S-2.54DSA(55)--3DModel-STEP-1.STEP, MDF7-5S-2.54DSA.stp, SM225-10E.STEP, apa102_led_array.kicad_pcb, apa102_led_array.kicad_sch, freerouting.dsn, magnetometer_array.kicad_pcb, magnetometer_array.kicad_sch]
2023-11-03 many changes
    [APA102 2020 LED.step, BSW-120-04-T-S.stp, BSW-120-X-X-S.step, BSW-134-04-L-S.stp, BSW-134-X-X-S.step, MDF7-5S-2.54DSA.stp, SAMTEC-SLW-105-01-X-S.step, SAMTEC-SLW-108-01-X-S.step]
2023-11-06 quadrillion changes
    [LDC 1101_click_v100.step, apa102_led_array.kicad_pcb, apa102_led_array.step, main_board-3.2.kicad_sch, main_board.kicad_pcb, main_board.kicad_sch, percussiveInterface-3.2.kicad_pcb, percussiveInterface-3.2.kicad_sch]
2023-11-09 almost there but not
    [BSW-112-04-T-S.stp, BSW-112-X-X-S.step, ESP32-S3-WROOM-1-N16R2.step, magnetometer_array_2.kicad_pcb, main_board-3.2.csv, main_board-3.2.kicad_sch]
2023-11-13 homework again
    [magnetometer_array_2.kicad_pcb, main_board-3.2.kicad_sch, mill-max-3907-0-18-01-30-XX-10-0.step]
2023-11-14 almost ahgsngarsn
    [magnetometer_array_3.kicad_pcb, magnetometer_array_3.kicad_sch, main_board_new-3.2.kicad_sch, mill-max-0558-0-15-15-30-XX-10-0.step, mill-max-0670-0-15-15-30-XX-10-0.step, mill-max-328-10-102-40-020001.STEP]
2023-11-15 jlc board
    [BOM-main_board_new-3.csv, RUT0012A.stp, bom.csv, designators.csv, magnetometer_array_3.kicad_pcb, magnetometer_array_3.step, main_board_4_jlc-3.2.kicad_pcb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]
2023-11-15 jlc board ...
    [BOM-main_board_4_jlc-3.csv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]
2023-11-19 full integrated with ti magnetometer
    [Grove - 2 Channel Inductive Sensor（LDC1612).brd, Grove - 2 Channel Inductive Sensor（LDC1612).sch, board_fully_integrated.kicad_pcb, board_fully_integrated.kicad_sch, ldc_grove.kicad_pcb, ldc_grove.kicad_sch]
2023-12-05 before production / pinout ESP IO
    [BOM-board_fully_integrated.csv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]
2023-12-14 Code slowly layed out
    [Shaft_Mount_Receiving_Coil.stl, nut_job_20160828-21486-ti2m8a-0.stl, receiver_coil_mount_part2.stl]
2023-12-20 fastTrig und so
2024-01-10 Logic Analyzer test SPI
2024-01-12 finaly reading all the sensors (uff)
